45duro/ProyectoBarredor/Materiales/Listado Materiales.xlsx

Producto | Cantidad | Costo | Total | Tienda
Base en L para Motor de 37MM | 4 | 7045 | 28180 | https://www.vistronica.com/robotica/accesorios-mecanicos/base-en-l-para-motor-de-37mm-detail.html
Motoreductor 18 kgcm | 4 | 76900 | 307600 | https://www.dynamoelectronics.com/motorreductores/536-motorreductor-18kgcm-80rpm.html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
