45duro/ProyectoBarredor/Chasis/ChasisConBasesMotor.SLDASM

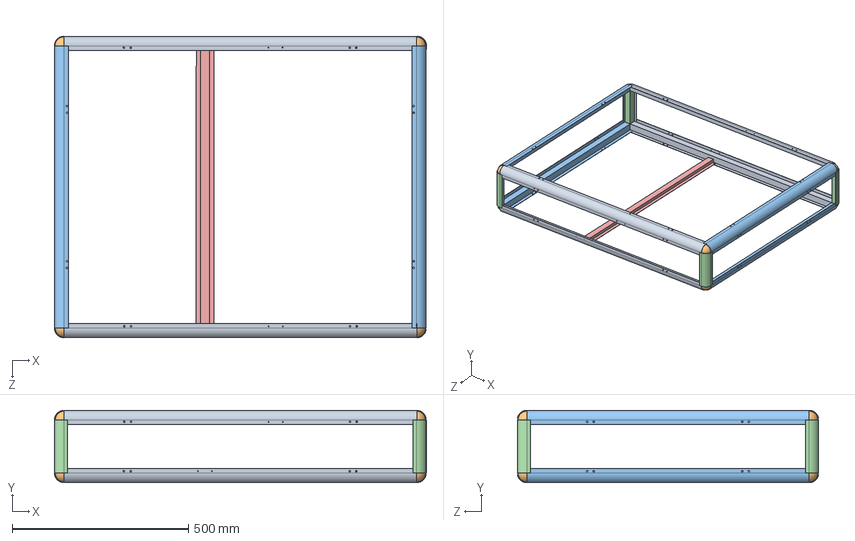
[picture p1: CAD file, 2019-09-19]
Chasis/ChasisConBasesMotor.SLDASM
1054.8 x 204.8 x 854.8 mm
Angulo x 4
Angulo 90 perfil x 8
AnguloFrontal x 4
AnguloParal x 4
Perfil Cuadrado
