45duro/ProyectoBarredor/Explosion Vista.SLDASM

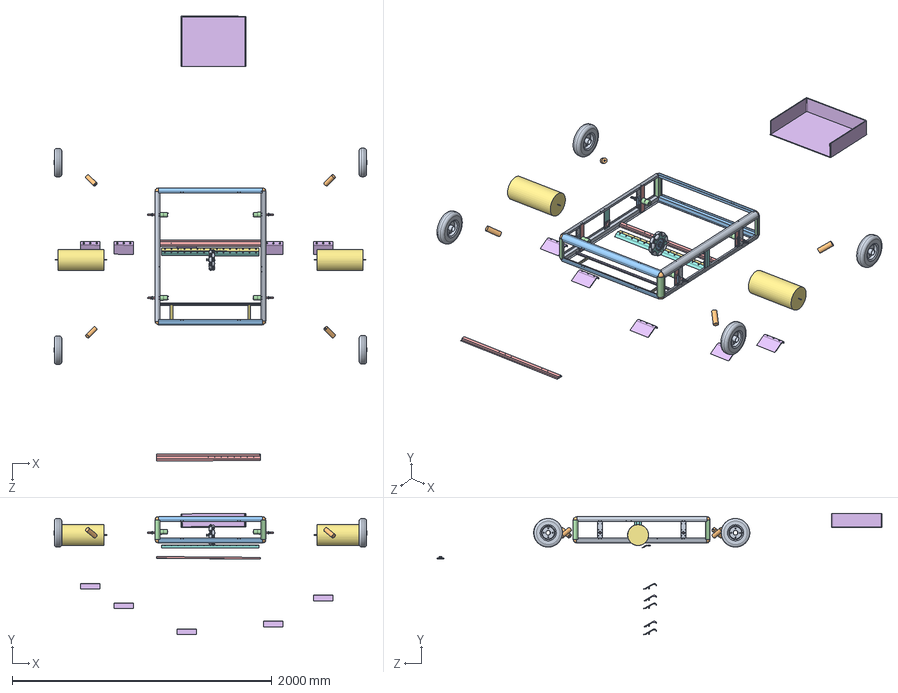
[picture p2: CAD file, 2019-09-28]
Explosion Vista.SLDASM
2407.9 x 934.3 x 3420.2 mm
Angulo x 4
Angulo 90 perfil x 8
AnguloFrontal x 4
AnguloParal x 4
Perfil Cuadrado x 2
pala2 x 5
protecto pala x 5
cinta flexy Recogedor
soporte Llantas x 4
instrument ball bearing_ai x 4
SOPORTE BALINERA x 4
hex jam nut_ai x 4
heavy hex finished bolt_ai x 4
soporte en T
soporte en T pequeño x 2
base1 x 2
tambor x 14
AdaptadorM2R
AdaptadorM3R
Soporte Lateral Rodillo x 2
Anillos Rodillo2 x 2
Cepillo x 2
Perfil Cuadrado 15cm x 2
Llanta x 4
Sujetadores Llantas x 4
Suplemento Transmision x 8
Motores Pololu x 4
soporte motor x 4
Canastilla
