45duro/ProyectoBarredor/Omnidireccion/LLanta OmniDir.SLDASM

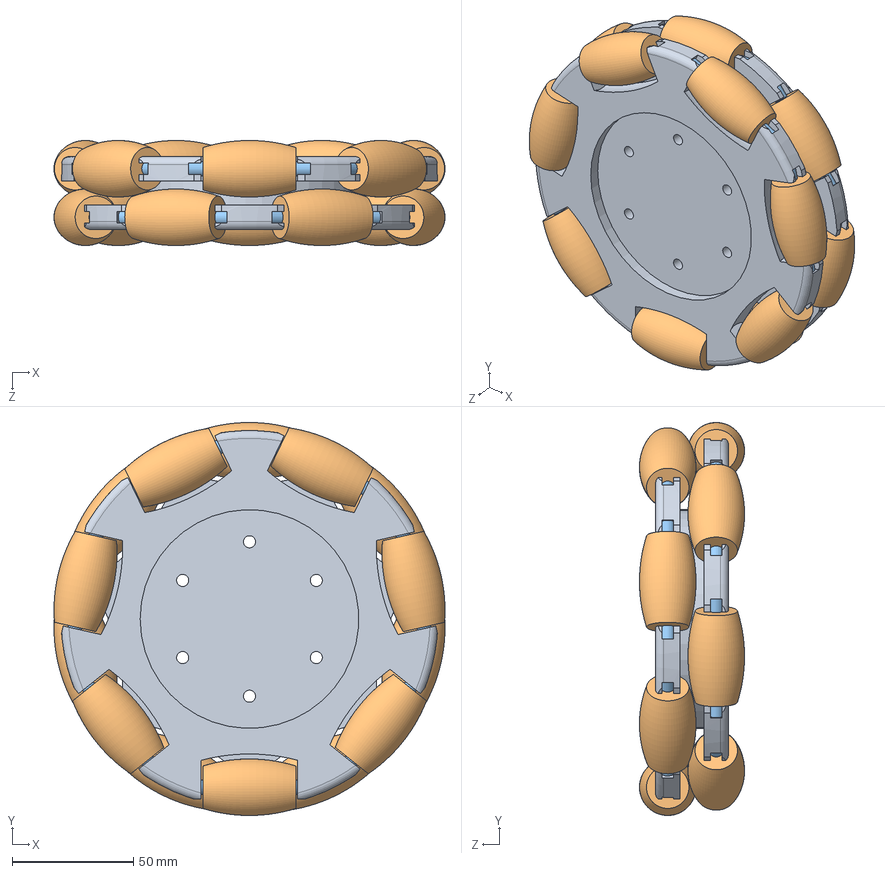
[picture p3: CAD file, 2019-09-19]
Omnidireccion/LLanta OmniDir.SLDASM
161.1 x 161.9 x 43.3 mm
base1 x 2
tambor x 14
