45duro/ProyectoBarredor/Chasis/Chasis Con Pala.SLDASM

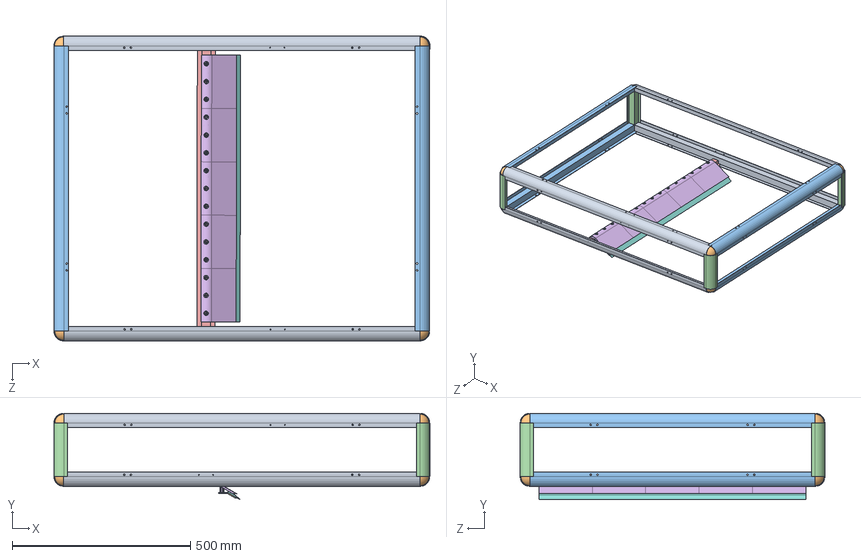
[picture p5: CAD file, 2019-09-19]
Chasis/Chasis Con Pala.SLDASM
1054.8 x 242.1 x 854.8 mm
Angulo x 4
Angulo 90 perfil x 8
AnguloFrontal x 4
AnguloParal x 4
Perfil Cuadrado
pala2 x 5
protecto pala x 5
cinta flexy Recogedor
