45duro/ProyectoBarredor/Pala Recogedor/Pala Final con cinta.SLDASM

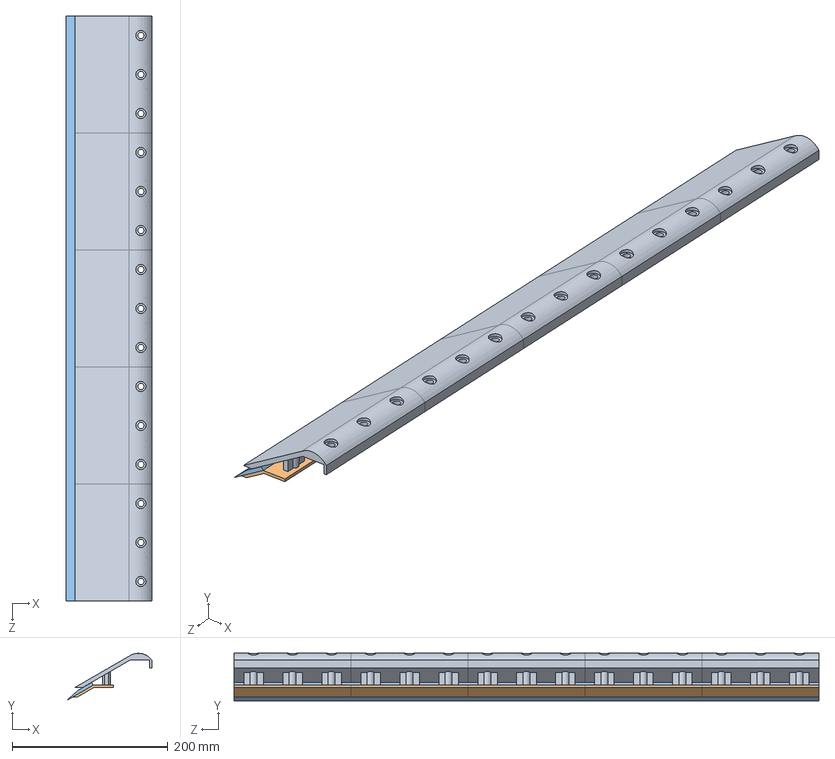
[picture p6: CAD file, 2019-09-17]
Pala Recogedor/Pala Final con cinta.SLDASM
109.8 x 60.9 x 750.0 mm
pala2 x 5
protecto pala x 5
cinta flexy Recogedor
