45duro/ProyectoBarredor/Sistema de Arrastre/Llanta Fija.SLDASM

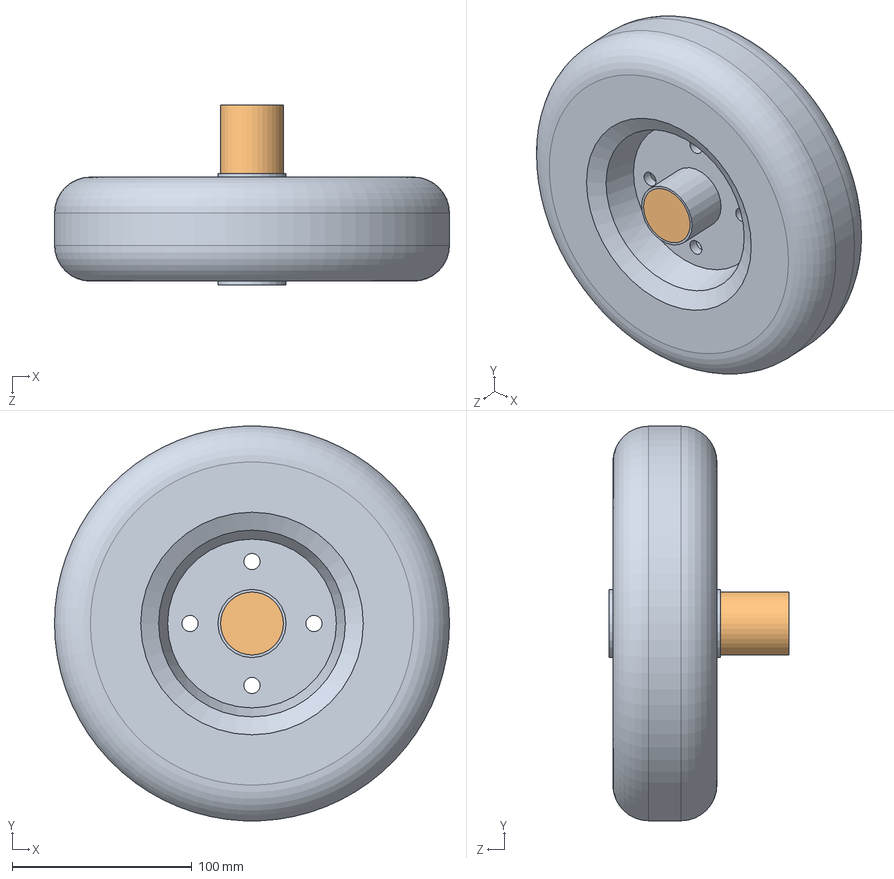
[picture p7: CAD file, 2019-09-19]
Sistema de Arrastre/Llanta Fija.SLDASM
220.0 x 219.8 x 100.0 mm
Llanta
Sujetadores Llantas
