45duro/ProyectoBarredor/Transmision/Soporte Principal Del Chasis.SLDASM

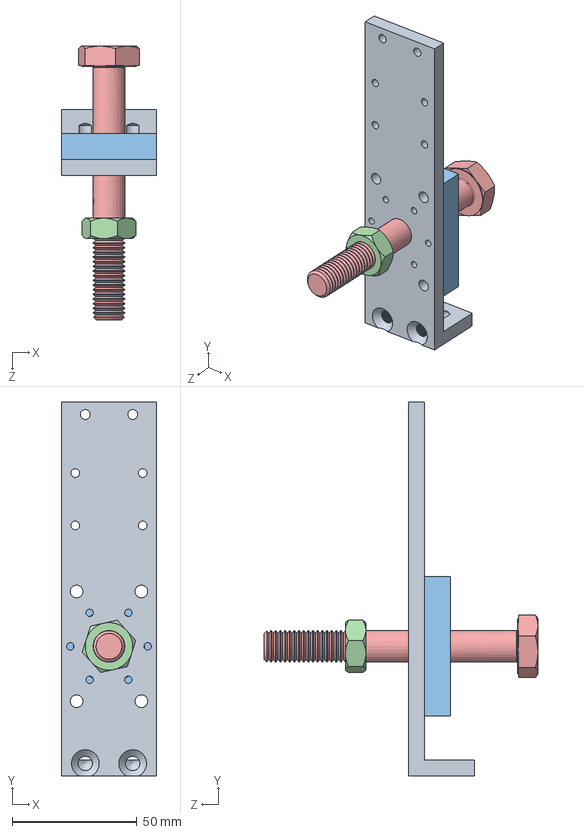
[picture p8: CAD file, 2019-09-19]
Transmision/Soporte Principal Del Chasis.SLDASM
38.0 x 150.0 x 109.8 mm
soporte Llantas
instrument ball bearing_ai
SOPORTE BALINERA
hex jam nut_ai
heavy hex finished bolt_ai
