45duro/ProyectoBarredor/Omnidireccion/OmniRueda.SLDASM

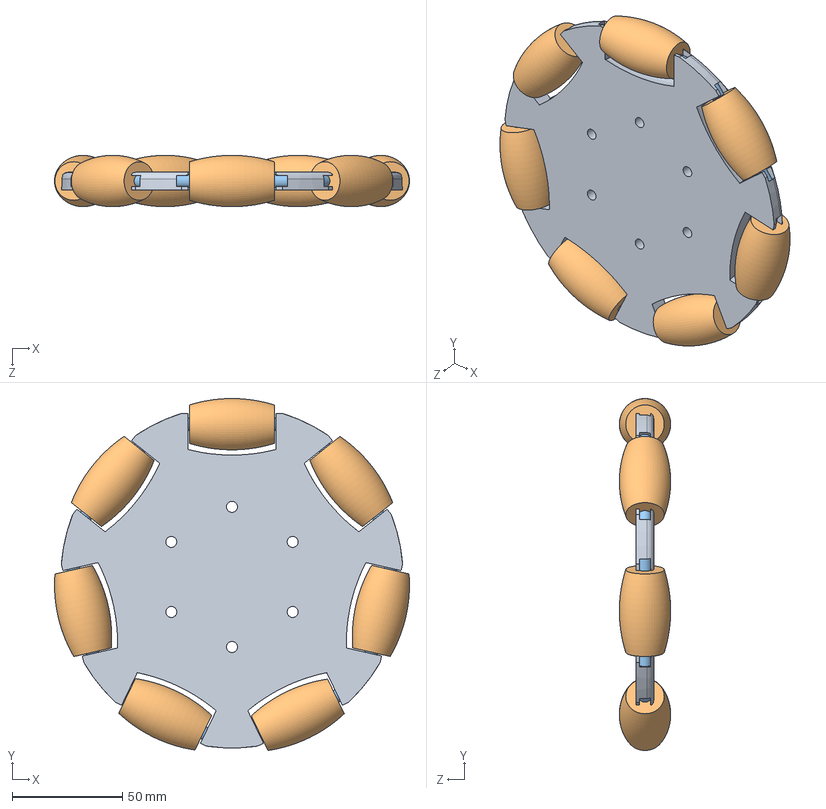
[picture p10: CAD file, 2019-09-19]
Omnidireccion/OmniRueda.SLDASM
161.1 x 159.7 x 23.3 mm
base1
tambor x 7
