45duro/ProyectoBarredor/Pala Recogedor/Pala Final.SLDASM

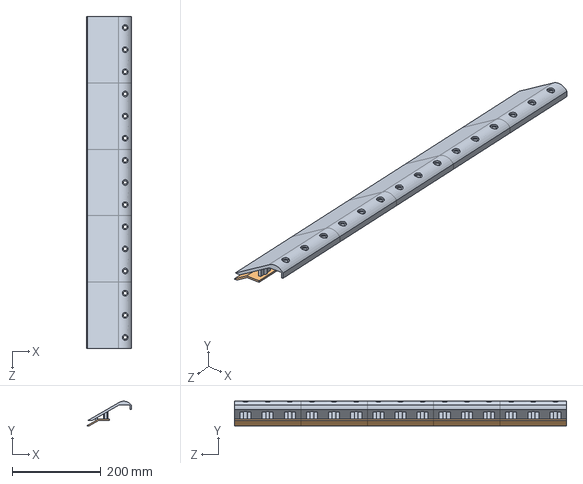
[picture p11: CAD file, 2019-09-17]
Pala Recogedor/Pala Final.SLDASM
101.0 x 55.9 x 750.0 mm
pala2 x 5
protecto pala x 5
