45duro/ProyectoBarredor/Perfiles/MarcoBaseParales.SLDASM

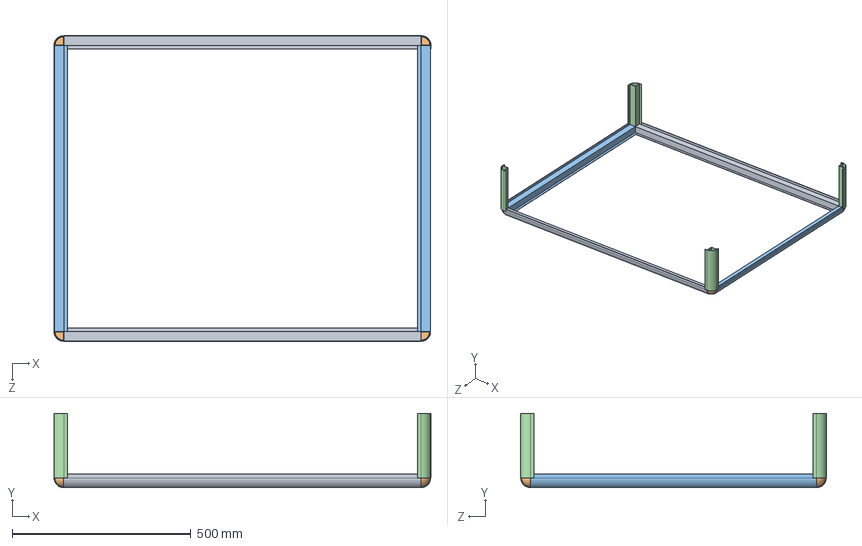
[picture p12: CAD file, 2019-09-17]
Perfiles/MarcoBaseParales.SLDASM
1054.8 x 207.4 x 854.8 mm
Angulo x 2
Angulo 90 perfil x 4
AnguloFrontal x 2
AnguloParal x 4
