45duro/ProyectoBarredor/Rodillo/Cepillo Completo.SLDASM

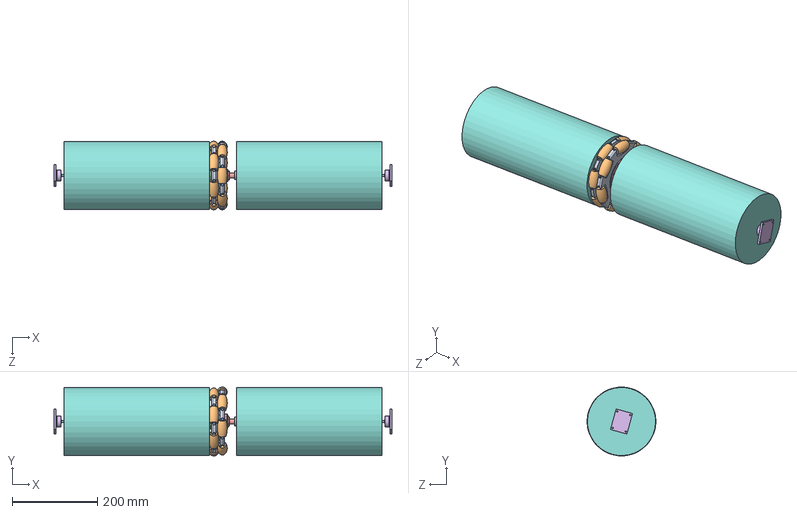
[picture p13: CAD file, 2019-09-19]
Rodillo/Cepillo Completo.SLDASM
793.7 x 161.9 x 161.1 mm
base1 x 2
tambor x 14
AdaptadorM2R
AdaptadorM3R
Soporte Lateral Rodillo x 2
Anillos Rodillo2 x 2
Cepillo x 2
