45duro/ProyectoBarredor/Transmision/Motor Montado.SLDASM

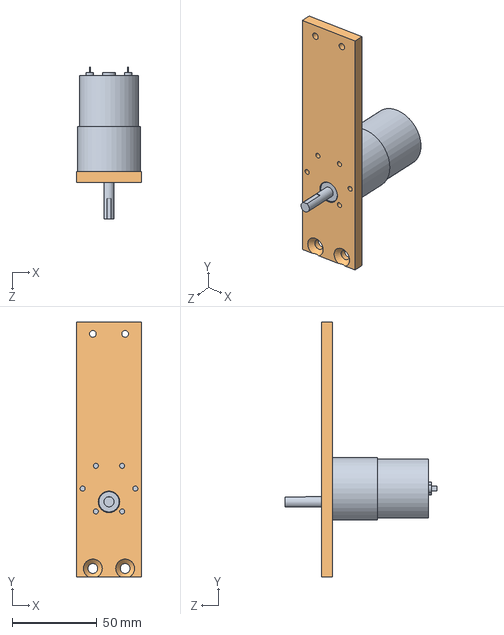
[picture p14: CAD file, 2019-09-19]
Transmision/Motor Montado.SLDASM
38.0 x 150.0 x 89.5 mm
Motores Pololu
soporte motor
