45duro/ProyectoBarredor/Rodillo/Cepillo Medio Ensamble.SLDASM

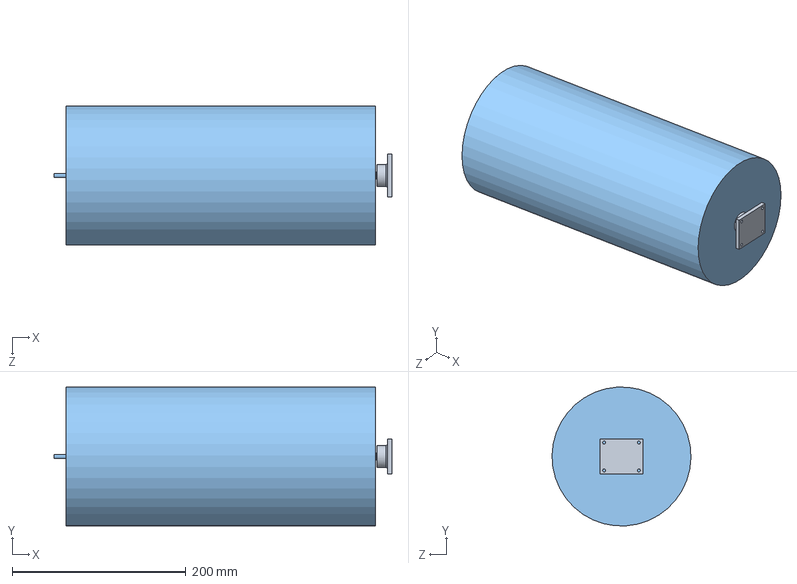
[picture p15: CAD file, 2019-09-19]
Rodillo/Cepillo Medio Ensamble.SLDASM
389.0 x 159.6 x 160.0 mm
Soporte Lateral Rodillo
Anillos Rodillo2
Cepillo
