45duro/ProyectoBarredor/Pala Recogedor/SoportePala.SLDASM

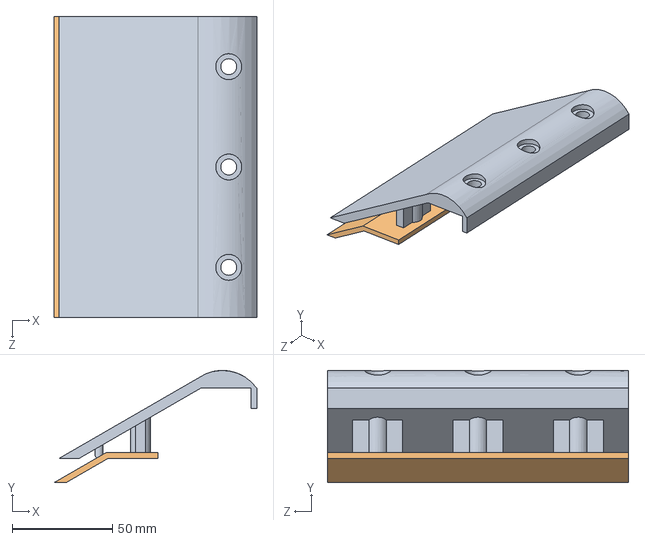
[picture p16: CAD file, 2019-09-17]
Pala Recogedor/SoportePala.SLDASM
101.0 x 55.9 x 150.0 mm
pala2
protecto pala
