45duro/ProyectoBarredor/Perfiles/MarcoBase.SLDASM

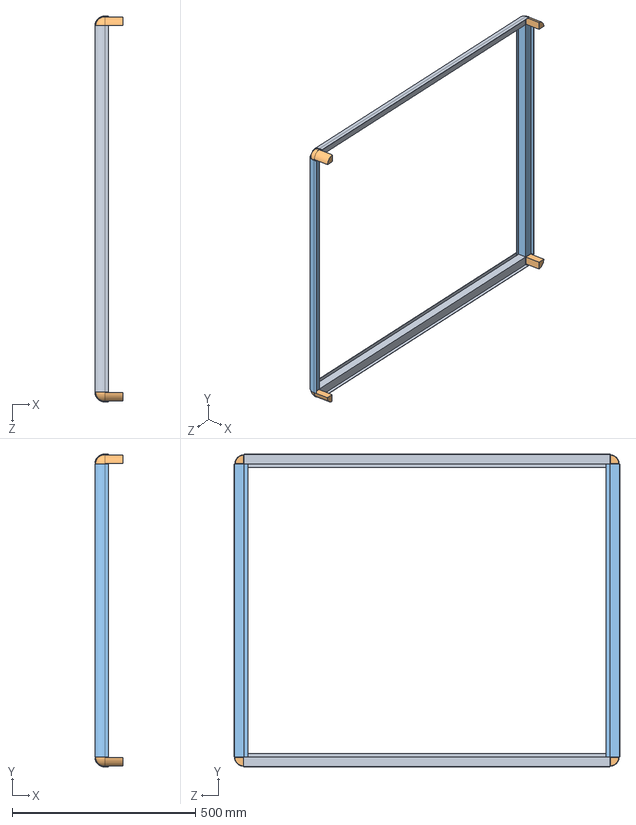
[picture p17: CAD file, 2019-09-17]
Perfiles/MarcoBase.SLDASM
77.4 x 854.8 x 1053.8 mm
Angulo x 2
Angulo 90 perfil x 4
AnguloFrontal x 2
