45duro/ProyectoBarredor/Pala Recogedor/Ensamblaje6.SLDASM

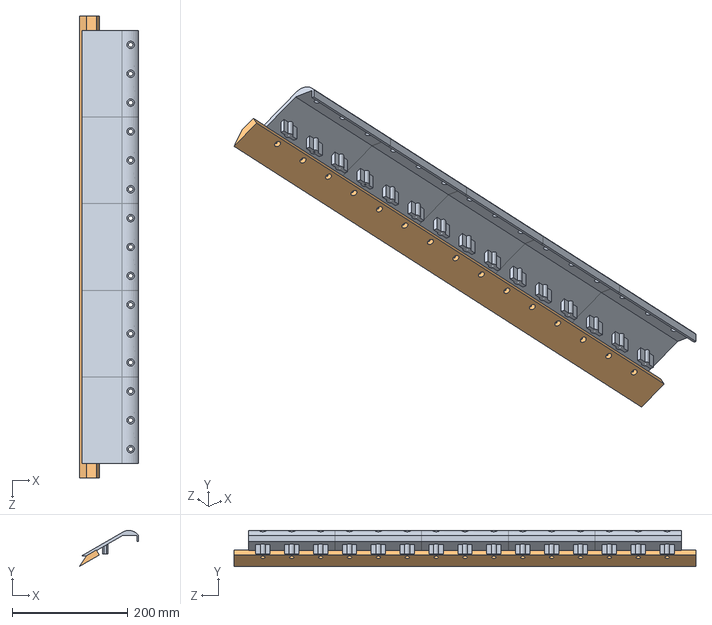
[picture p18: CAD file, 2019-08-01]
Pala Recogedor/Ensamblaje6.SLDASM
102.9 x 62.5 x 800.0 mm
pala2 x 5
cinta flexy Recogedor
