45duro/ProyectoBarredor/Omnidireccion/Rueda Doble Emsablada.SLDASM

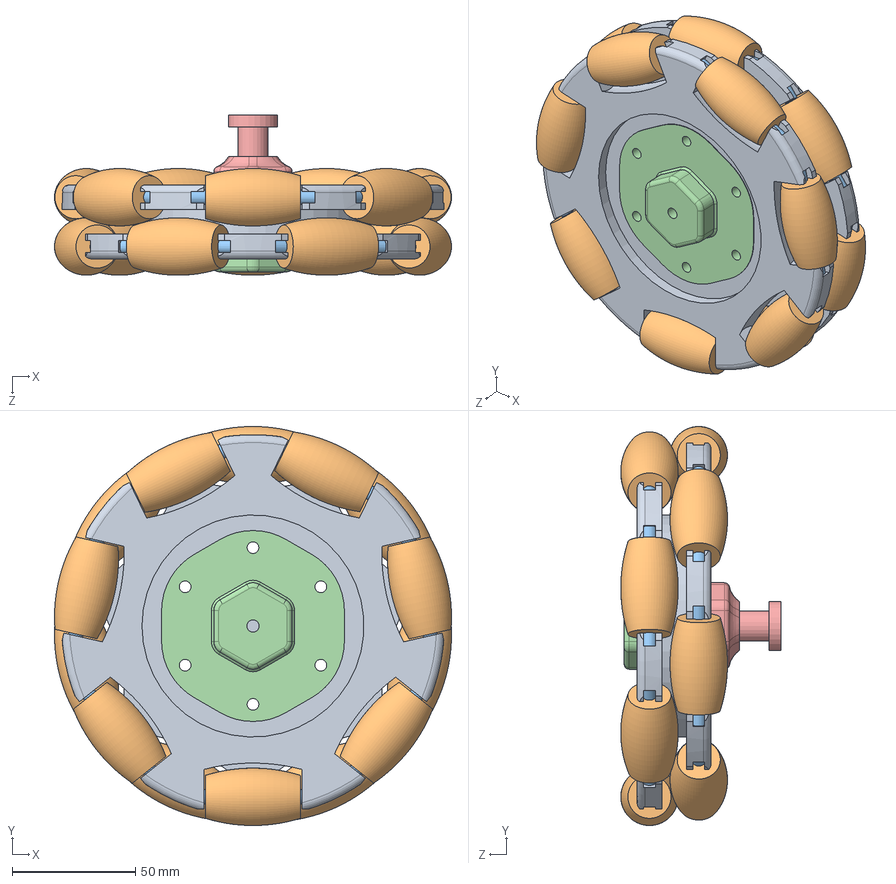
[picture p19: CAD file, 2019-09-19]
Omnidireccion/Rueda Doble Emsablada.SLDASM
161.1 x 161.9 x 65.1 mm
base1 x 2
tambor x 14
AdaptadorM2R
AdaptadorM3R
