45duro/ProyectoBarredor/Pala Recogedor/PALAS UNIDAS.SLDASM

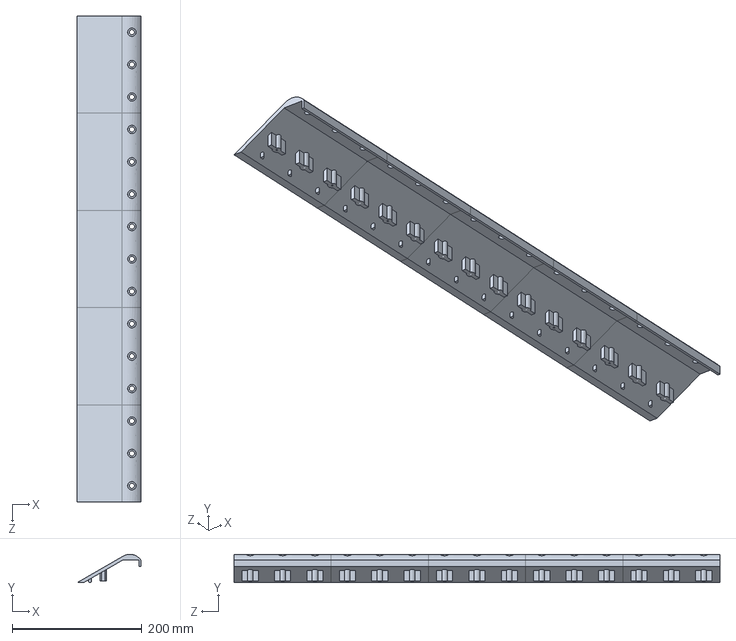
[picture p20: CAD file, 2019-08-01]
Pala Recogedor/PALAS UNIDAS.SLDASM
98.6 x 43.9 x 750.0 mm
pala2 x 5
