45duro/ProyectoBarredor/Canasta/Canastilla.SLDPRT

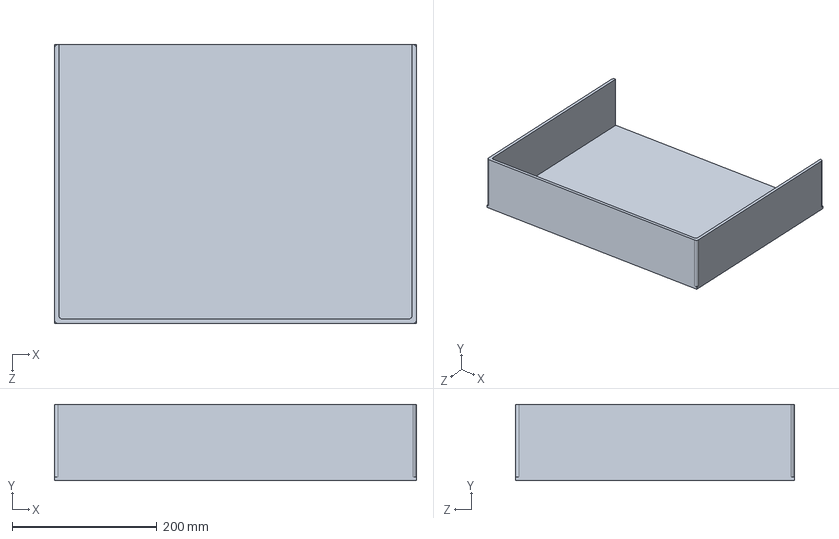
[picture p21: CAD file, 2019-09-19]
Canasta/Canastilla.SLDPRT
500.0 x 105.0 x 385.0 mm
