45duro/ProyectoBarredor/Pala Recogedor/cinta flexy Recogedor.SLDPRT

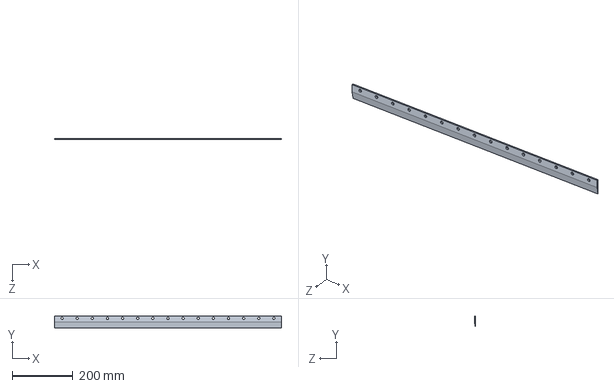
[picture p22: CAD file, 2019-09-17]
Pala Recogedor/cinta flexy Recogedor.SLDPRT
750.0 x 40.0 x 4.00 mm
