45duro/ProyectoBarredor/Perfiles/Perfil Cuadrado 15cm.SLDPRT

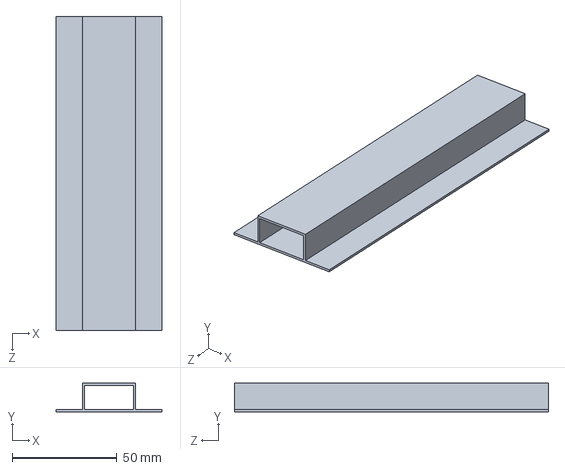
[picture p23: CAD file, 2019-09-19]
Perfiles/Perfil Cuadrado 15cm.SLDPRT
50.8 x 13.7 x 150.0 mm
