45duro/ProyectoBarredor/Rodillo/Anillos Rodillo2.SLDPRT

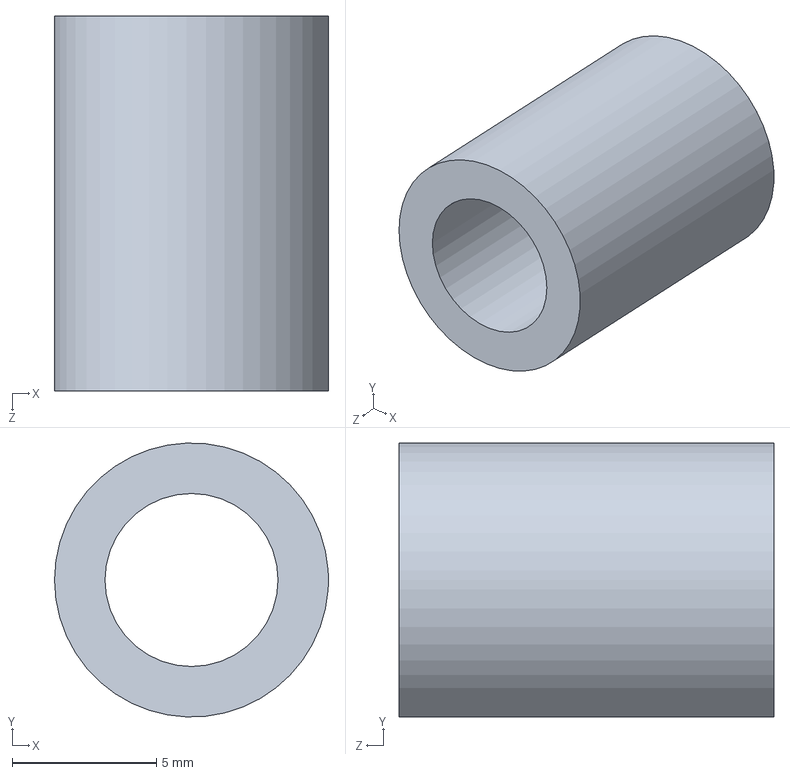
[picture p24: CAD file, 2019-09-19]
Rodillo/Anillos Rodillo2.SLDPRT
9.50 x 9.49 x 13.0 mm
