45duro/ProyectoBarredor/Sistema de Arrastre/Motores Pololu.SLDPRT

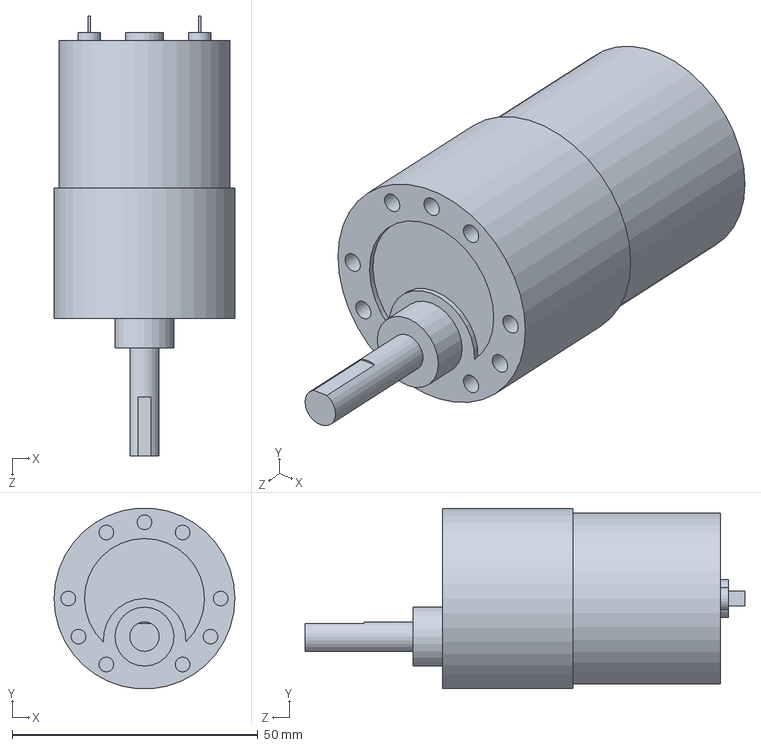
[picture p25: CAD file, 2019-11-28]
Sistema de Arrastre/Motores Pololu.SLDPRT
36.8 x 36.7 x 89.5 mm
