45duro/ProyectoBarredor/Transmision/soporte motor.SLDPRT

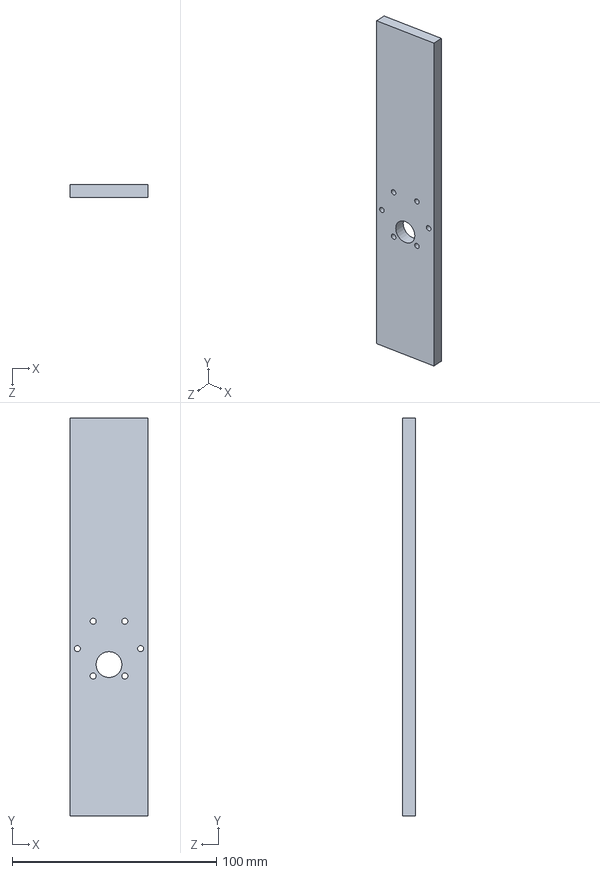
[picture p26: CAD file, 2019-09-19]
Transmision/soporte motor.SLDPRT
38.0 x 195.0 x 6.35 mm
