45duro/ProyectoBarredor/Omnidireccion/Part1.SLDPRT

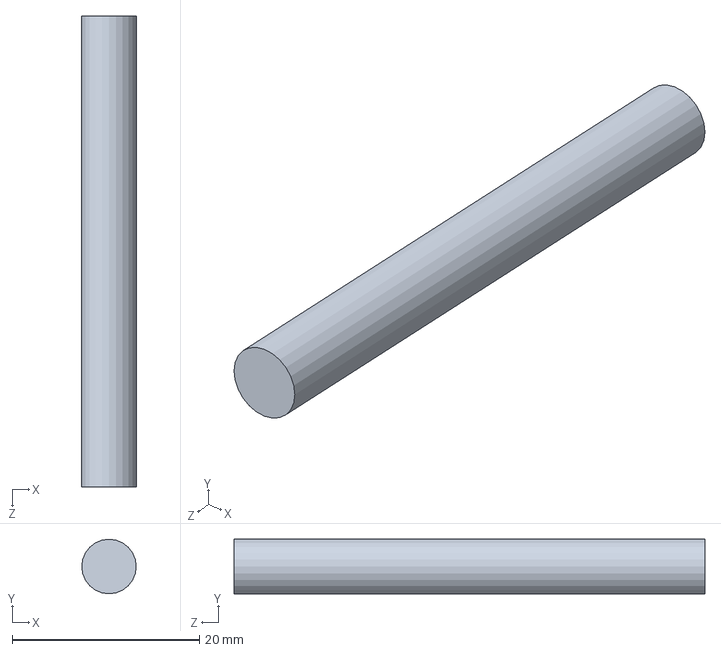
[picture p27: CAD file, 2019-09-19]
Omnidireccion/Part1.SLDPRT
5.83 x 5.83 x 50.3 mm
