45duro/ProyectoBarredor/Perfiles/soporte en T.SLDPRT

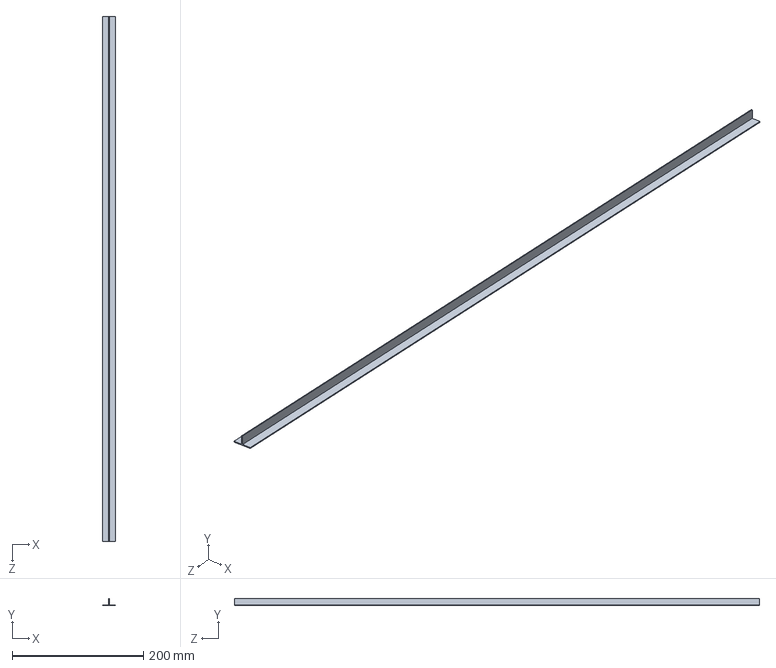
[picture p28: CAD file, 2019-09-17]
Perfiles/soporte en T.SLDPRT
20.0 x 10.5 x 800.0 mm
