45duro/ProyectoBarredor/Rodillo/Cepillo.SLDPRT

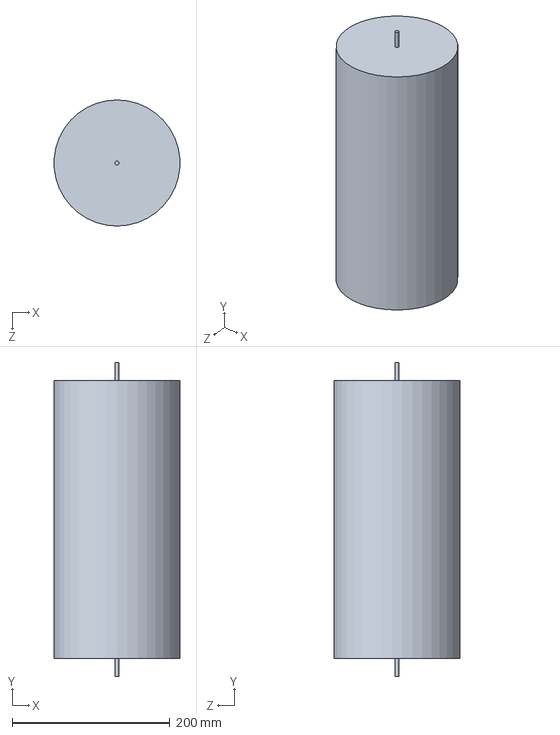
[picture p29: CAD file, 2019-09-19]
Rodillo/Cepillo.SLDPRT
159.5 x 398.4 x 160.0 mm
