45duro/ProyectoBarredor/STL/tambor.STL

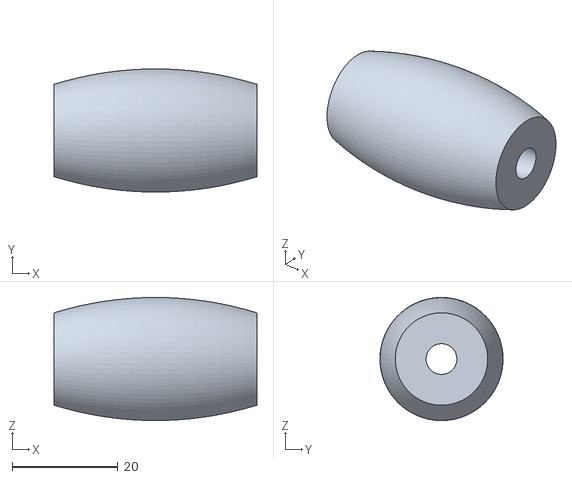
[picture p30: CAD file, 2019-08-01]
STL/tambor.STL
38.4 x 23.3 x 23.3
