45duro/ProyectoBarredor/Pala Recogedor/protecto pala.SLDPRT

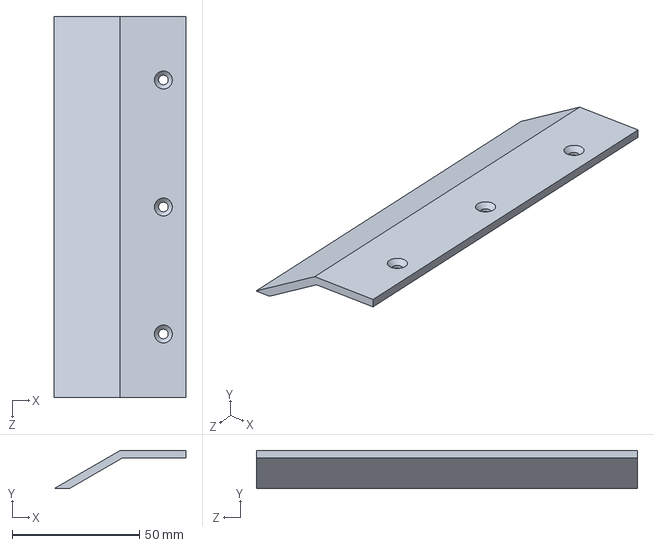
[picture p31: CAD file, 2019-09-17]
Pala Recogedor/protecto pala.SLDPRT
51.8 x 15.0 x 150.0 mm
