45duro/ProyectoBarredor/Perfiles/Angulo 90 perfil.SLDPRT

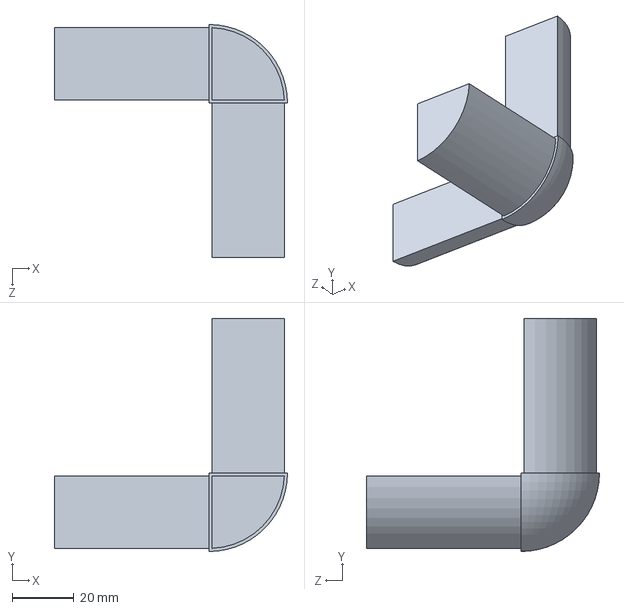
[picture p32: CAD file, 2019-09-17]
Perfiles/Angulo 90 perfil.SLDPRT
75.4 x 75.4 x 75.4 mm
