45duro/ProyectoBarredor/Rodillo/Soporte Lateral Rodillo.SLDPRT

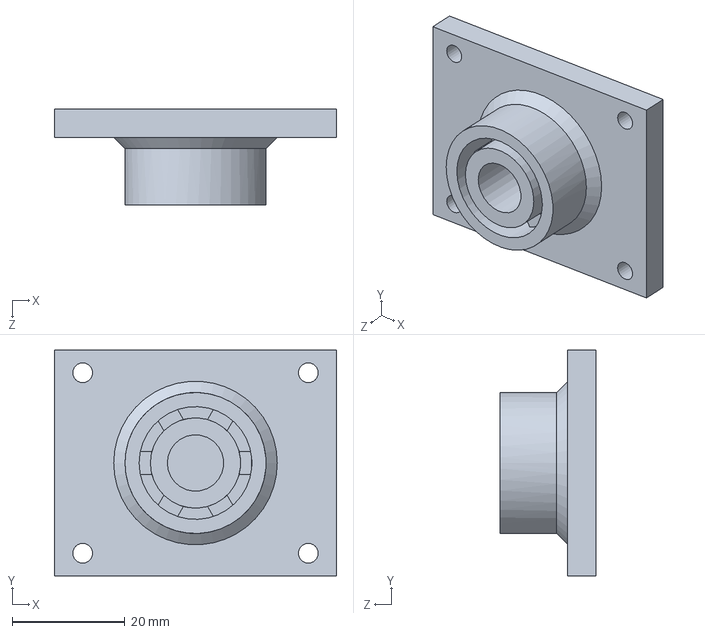
[picture p33: CAD file, 2019-09-19]
Rodillo/Soporte Lateral Rodillo.SLDPRT
50.0 x 40.0 x 17.0 mm
