45duro/ProyectoBarredor/Sistema de Arrastre/Sujetadores Llantas.SLDPRT

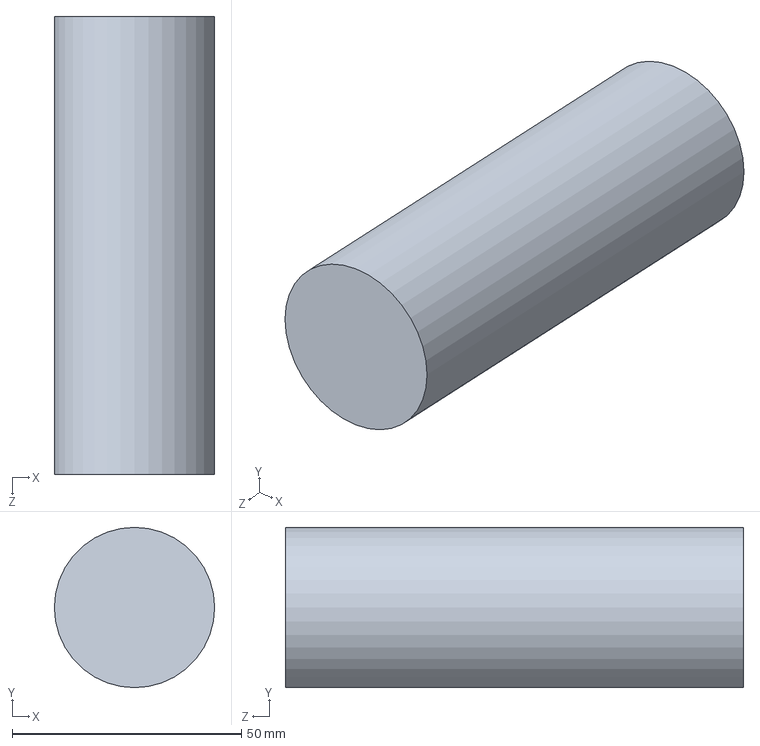
[picture p34: CAD file, 2019-09-19]
Sistema de Arrastre/Sujetadores Llantas.SLDPRT
35.0 x 35.0 x 100.0 mm
