45duro/ProyectoBarredor/Transmision/soporte Llantas.SLDPRT

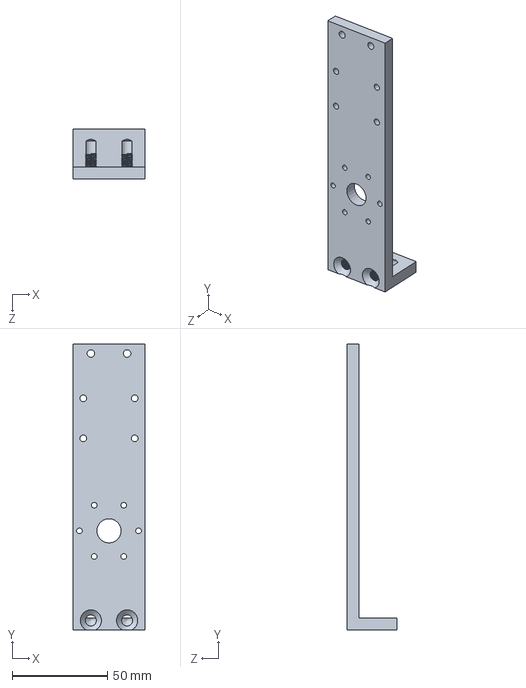
[picture p35: CAD file, 2019-09-19]
Transmision/soporte Llantas.SLDPRT
38.0 x 150.0 x 26.3 mm
