45duro/ProyectoBarredor/Omnidireccion/AdaptadorM2R.SLDPRT

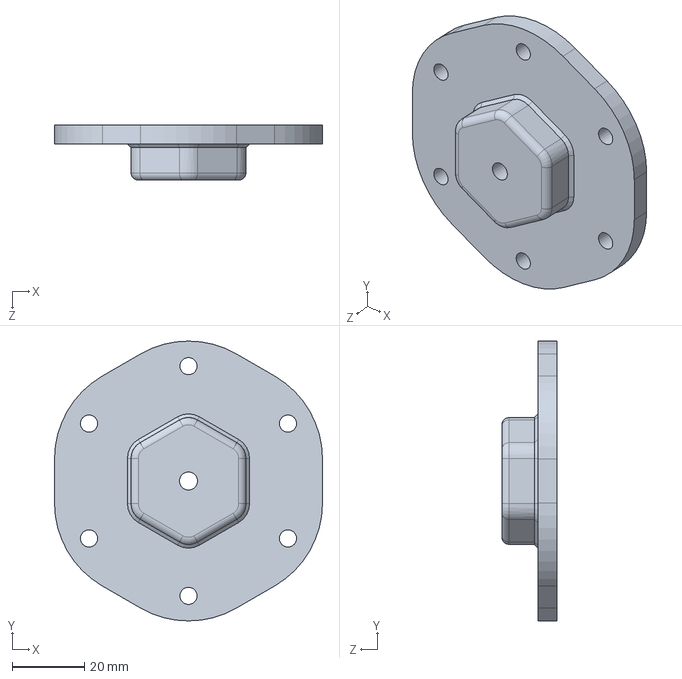
[picture p36: CAD file, 2019-09-19]
Omnidireccion/AdaptadorM2R.SLDPRT
74.2 x 77.5 x 15.3 mm
