45duro/ProyectoBarredor/Sistema de Arrastre/Llanta.SLDPRT

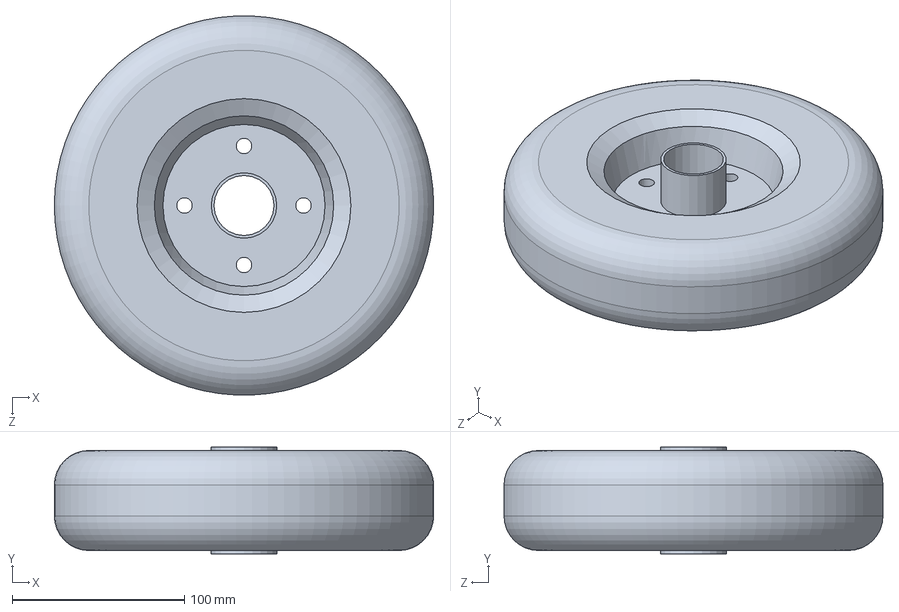
[picture p37: CAD file, 2019-09-19]
Sistema de Arrastre/Llanta.SLDPRT
220.0 x 62.0 x 219.8 mm
