45duro/ProyectoBarredor/STL/AdaptadorM3R.STL

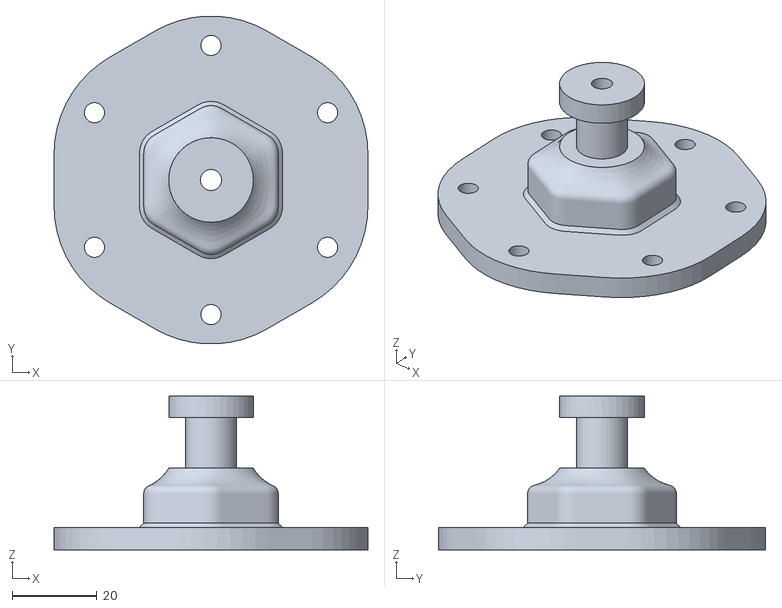
[picture p38: CAD file, 2019-08-01]
STL/AdaptadorM3R.STL
74.2 x 77.4 x 36.3
