45duro/ProyectoBarredor/Pala Recogedor/pala2.SLDPRT

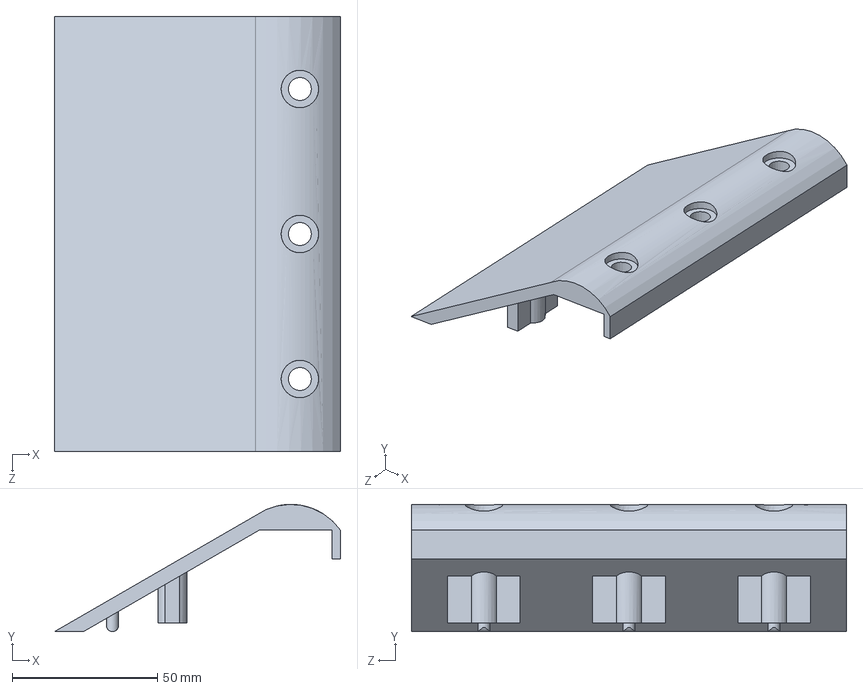
[picture p39: CAD file, 2019-09-17]
Pala Recogedor/pala2.SLDPRT
98.6 x 43.9 x 150.0 mm
