45duro/ProyectoBarredor/Perfiles/Angulo.SLDPRT

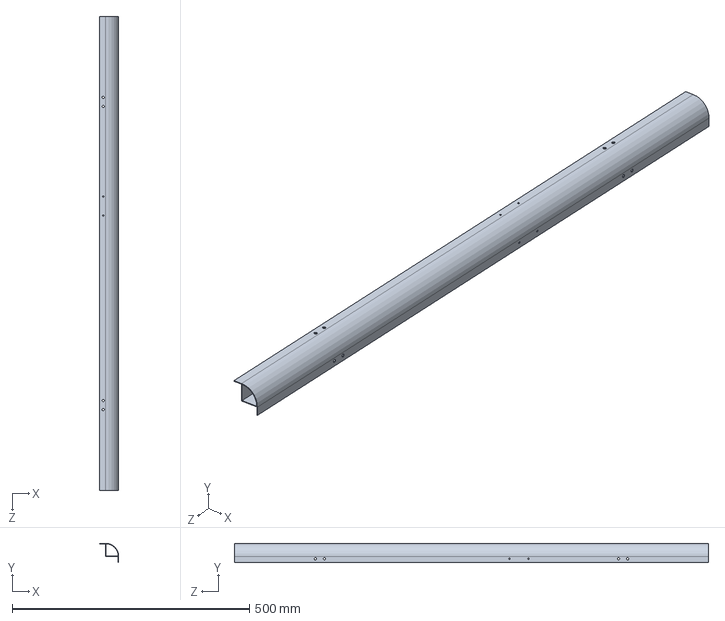
[picture p40: CAD file, 2019-09-17]
Perfiles/Angulo.SLDPRT
40.4 x 40.4 x 1000.0 mm
