45duro/ProyectoBarredor/Transmision/Ejes LLantas.SLDPRT

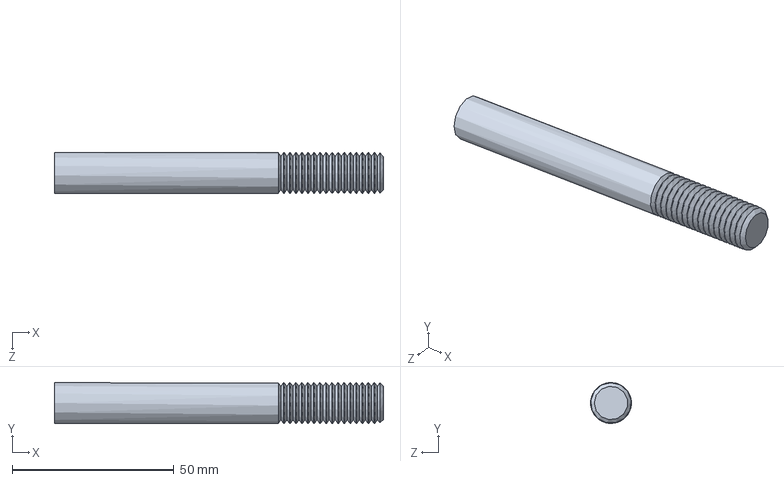
[picture p41: CAD file, 2019-09-19]
Transmision/Ejes LLantas.SLDPRT
101.9 x 12.7 x 12.7 mm
