45duro/ProyectoBarredor/Omnidireccion/base1.SLDPRT

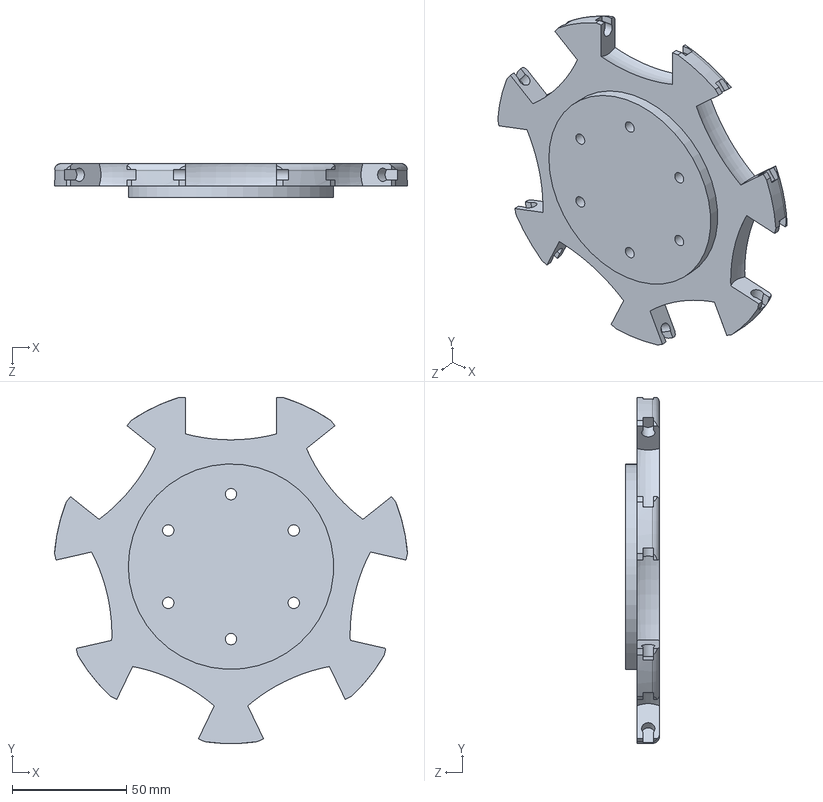
[picture p42: CAD file, 2019-09-19]
Omnidireccion/base1.SLDPRT
154.8 x 151.7 x 15.0 mm
