45duro/ProyectoBarredor/Transmision/SOPORTE BALINERA.SLDPRT

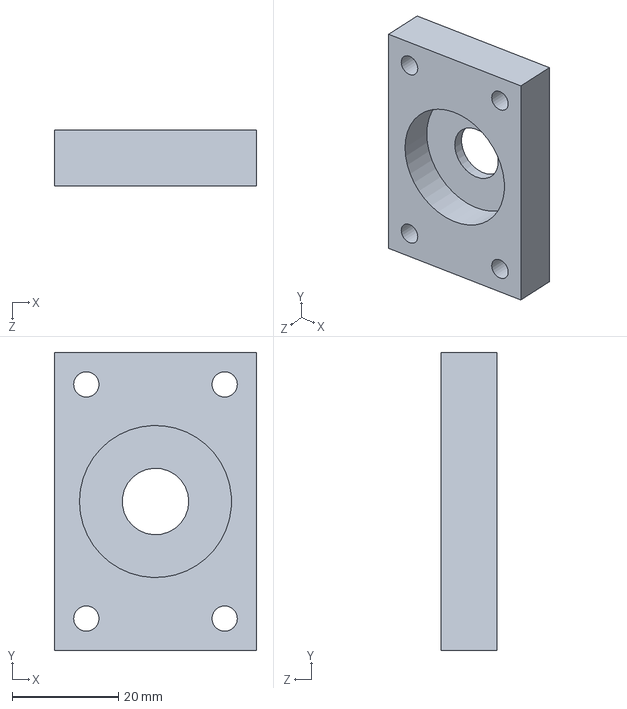
[picture p43: CAD file, 2019-09-17]
Transmision/SOPORTE BALINERA.SLDPRT
38.0 x 56.0 x 10.5 mm
