45duro/ProyectoBarredor/Perfiles/soporte en T pequeño.SLDPRT

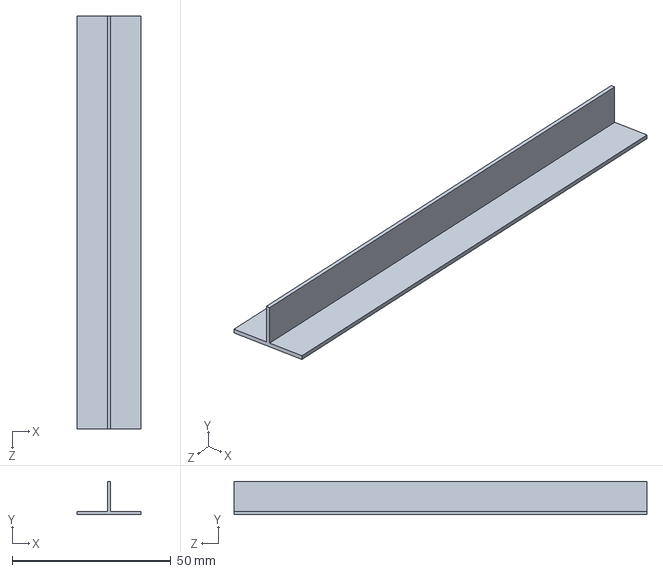
[picture p44: CAD file, 2019-09-17]
Perfiles/soporte en T pequeño.SLDPRT
20.0 x 10.5 x 130.0 mm
