45duro/ProyectoBarredor/STL/Anillos Rodillo.STL

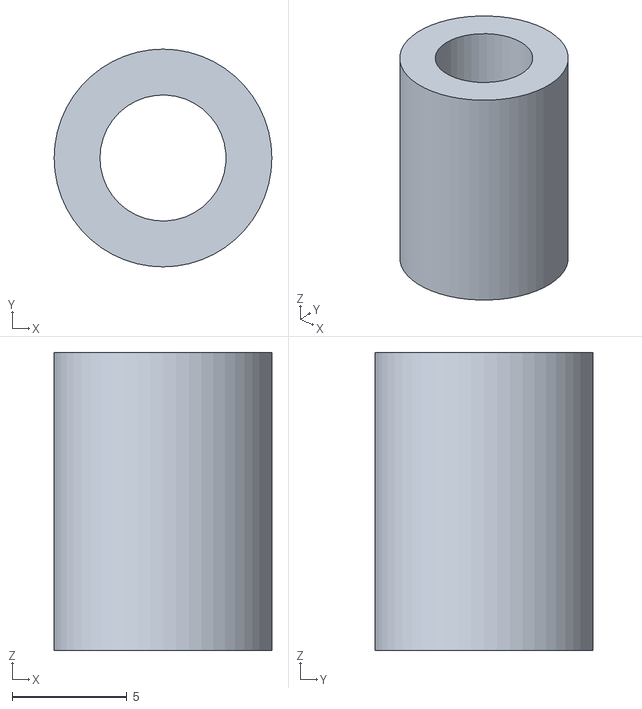
[picture p45: CAD file, 2019-08-01]
STL/Anillos Rodillo.STL
9.50 x 9.50 x 13.0
