45duro/ProyectoBarredor/Transmision/Tuerca.SLDPRT

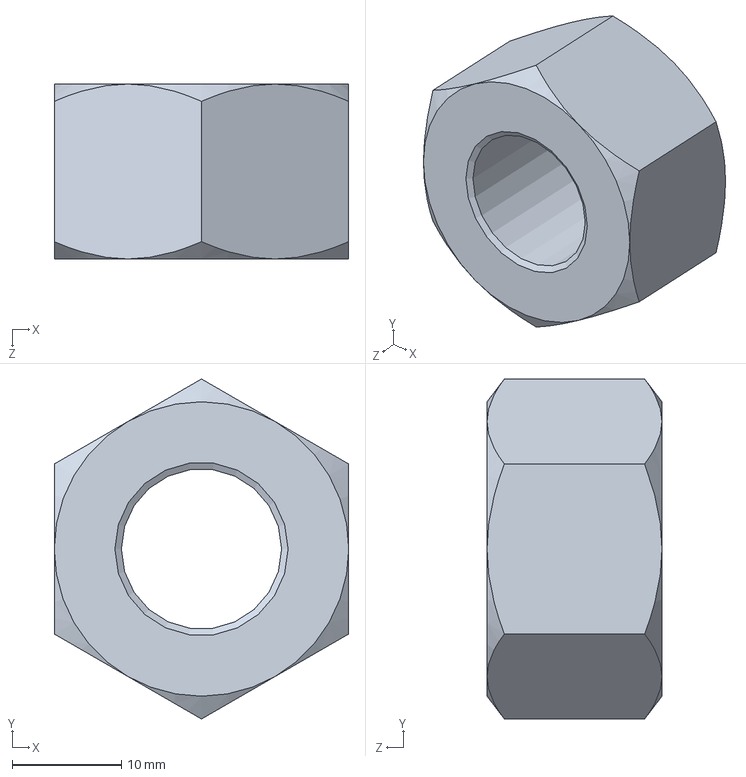
[picture p46: CAD file, 2019-09-17]
Transmision/Tuerca.SLDPRT
27.0 x 31.1 x 16.0 mm
