45duro/ProyectoBarredor/Perfiles/Perfil Cuadrado.SLDPRT

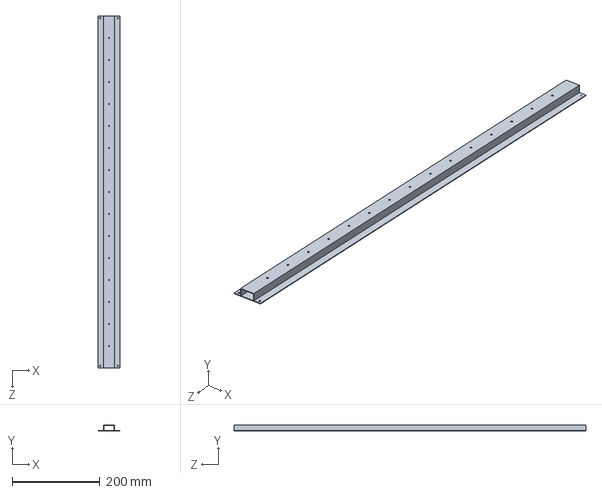
[picture p47: CAD file, 2019-09-17]
Perfiles/Perfil Cuadrado.SLDPRT
50.8 x 13.7 x 800.0 mm
