45duro/ProyectoBarredor/Transmision/Rodamiento Rodillo Llanta.sldprt

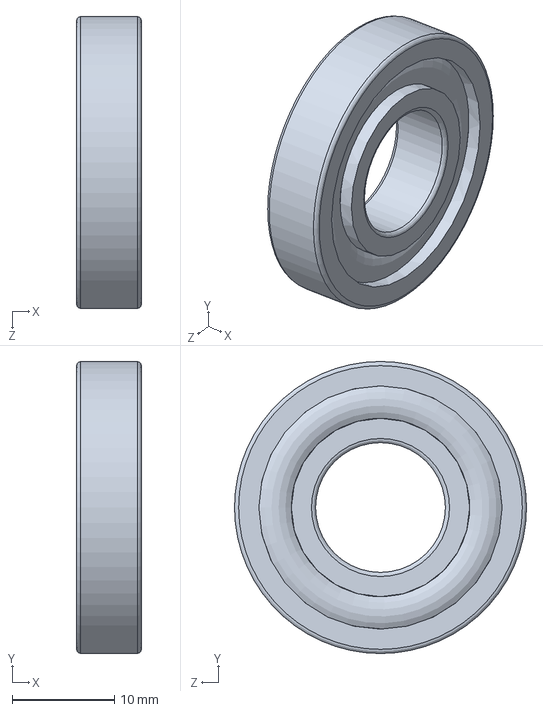
[picture p48: CAD file, 2019-09-17]
Transmision/Rodamiento Rodillo Llanta.sldprt
6.35 x 28.6 x 28.6 mm
