45duro/ProyectoBarredor/Perfiles/AnguloParal.SLDPRT

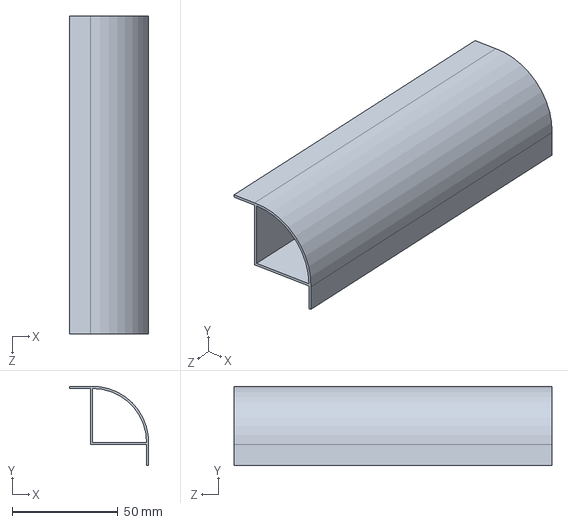
[picture p49: CAD file, 2019-09-17]
Perfiles/AnguloParal.SLDPRT
37.4 x 37.4 x 150.0 mm
