45duro/ProyectoBarredor/Transmision/Suplemento Transmision.SLDPRT

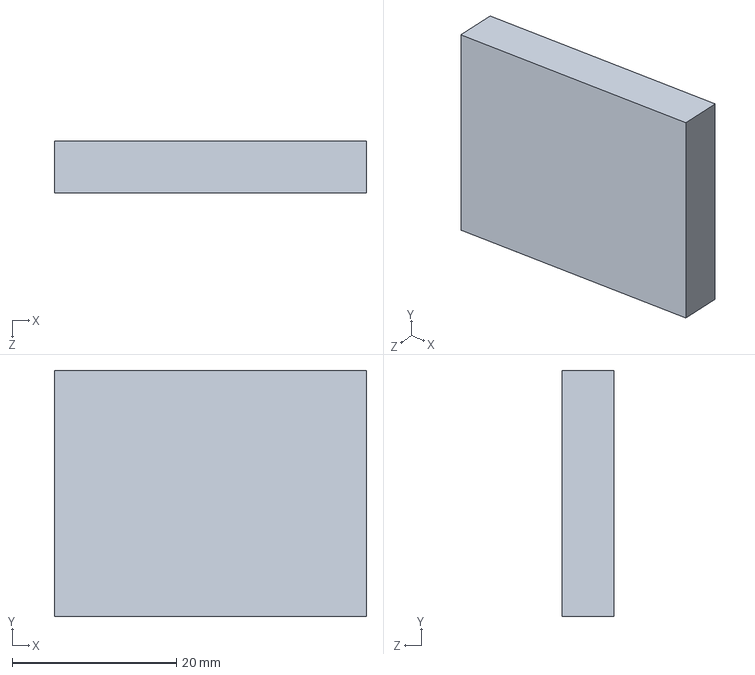
[picture p50: CAD file, 2019-09-17]
Transmision/Suplemento Transmision.SLDPRT
38.0 x 30.0 x 6.35 mm
