45duro/ProyectoBarredor/Perfiles/AnguloFrontal.SLDPRT

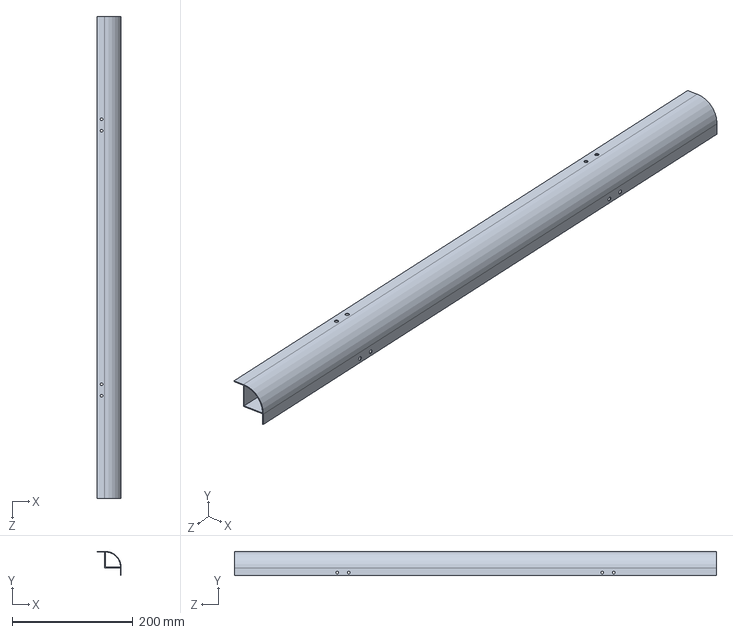
[picture p51: CAD file, 2019-09-17]
Perfiles/AnguloFrontal.SLDPRT
40.4 x 40.4 x 800.0 mm
