45duro/ProyectoBarredor/STL/acople Llanta.STL

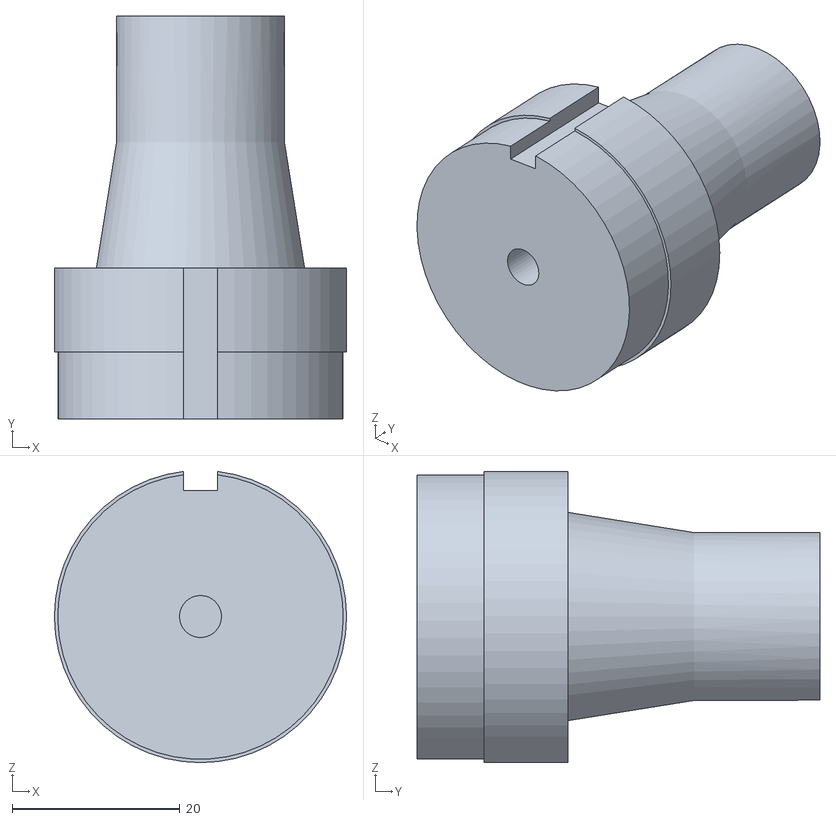
[picture p52: CAD file, 2019-07-26]
STL/acople Llanta.STL
34.8 x 48.0 x 34.7
