45duro/ProyectoBarredor/(list of files, cad)

Other CAD files:
STL/Anillos Rodillo2.STL
STL/soportes Laterales Rodillo.STL
Omnidireccion/tambor.SLDPRT
STL/AdaptadorM2R.STL
STL/base1 omni.STL
Omnidireccion/AdaptadorM3R.SLDPRT
STL/protector pala.STL
STL/pala.STL
Transmision/Motores Pololu.SLDPRT
Omnidireccion/AdaptadorM2R.STL
Omnidireccion/base1.STL
Omnidireccion/tambor.STL
PLANOS PDF/AdaptadorM2R.SLDDRW
PLANOS PDF/AdaptadorM3R.SLDDRW
PLANOS PDF/Angulo 90 perfil.SLDDRW
PLANOS PDF/AnguloParal.SLDDRW
PLANOS PDF/Anillos Rodillo2.SLDDRW
PLANOS PDF/Chasis Completo.SLDDRW
PLANOS PDF/Llanta Fija.SLDDRW
PLANOS PDF/Motores Pololu.SLDDRW
PLANOS PDF/Perfil Cuadrado 15cm.SLDDRW
PLANOS PDF/Soporte Lateral Rodillo.SLDDRW
PLANOS PDF/base1 omni.SLDDRW
PLANOS PDF/pala2.SLDDRW
PLANOS PDF/protecto pala.SLDDRW
PLANOS PDF/tambor.SLDDRW
Perfiles/soporte en T.SLDDRW
Transmision/SOPORTE BALINERA.SLDDRW
Transmision/soporte Llantas.SLDDRW
