45duro/ProyectoBarredor/PLANOS PDF/Angulo 90 perfil - Hoja1.pdf

E E

F F

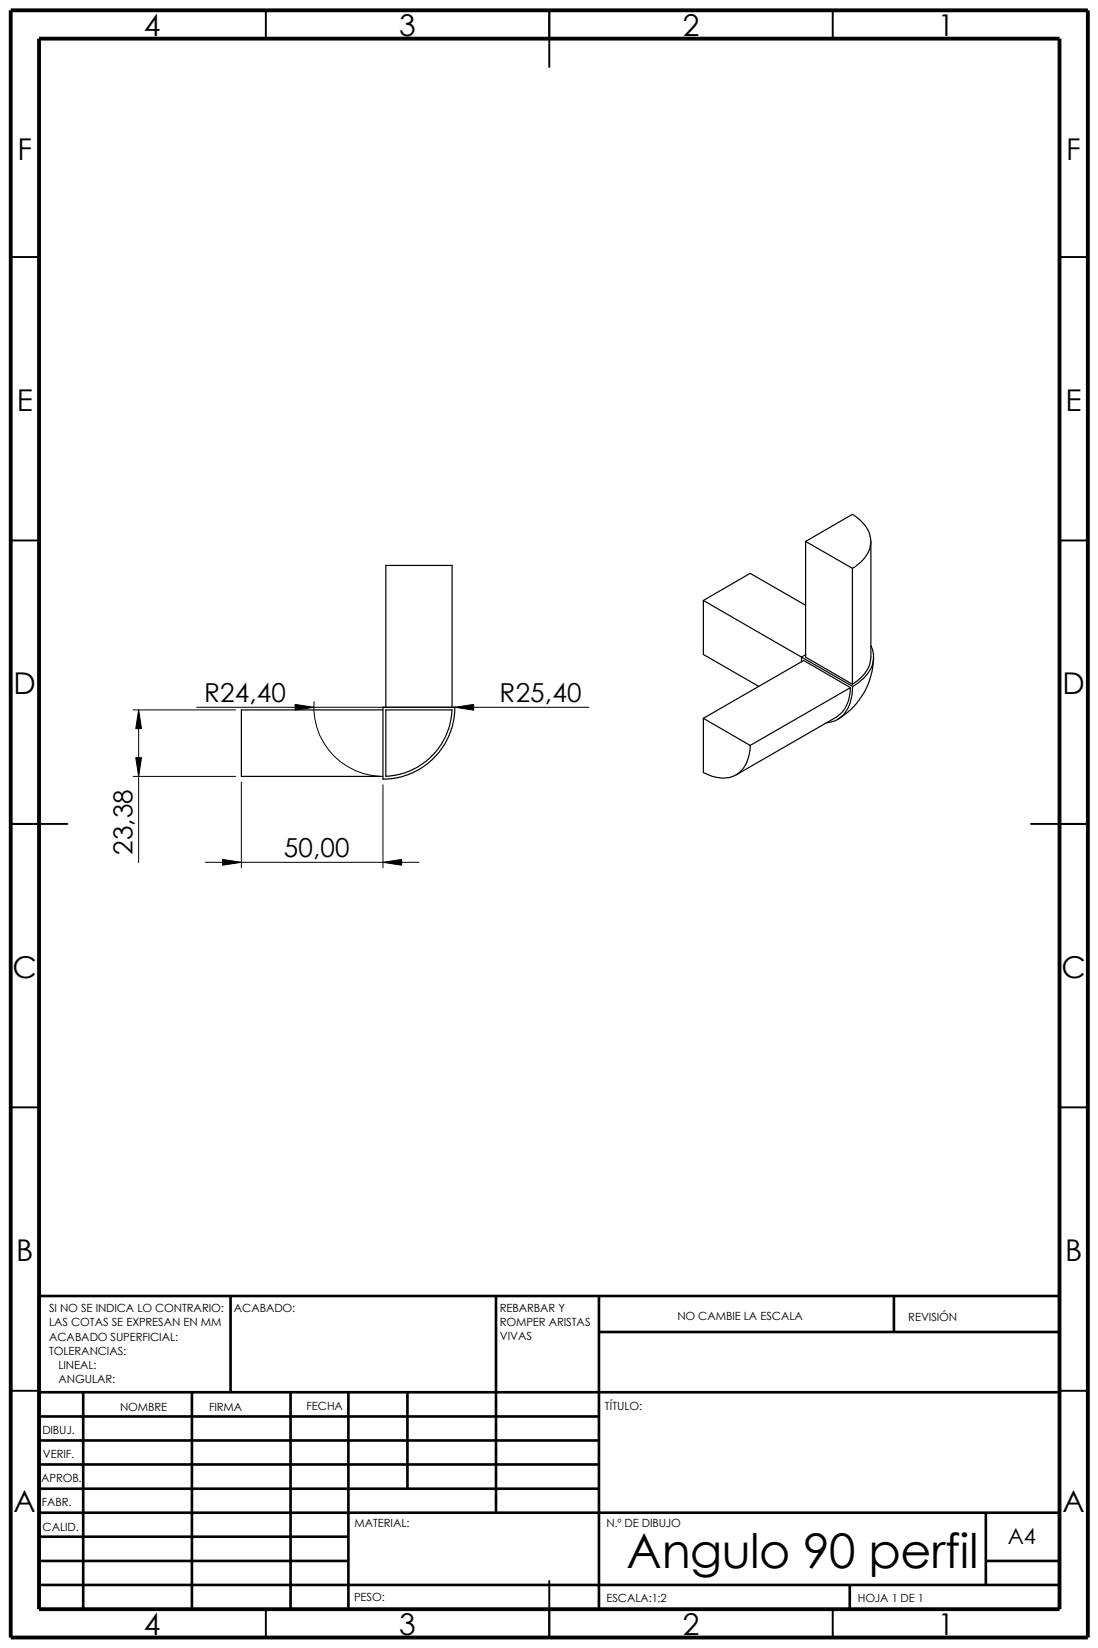
[picture p58: page 1]
ESCALA:1:2; HOJA 1 DE 1; PESO:; N.º DE DIBUJO; REVISIÓN; MATERIAL:; FABR.; CALID.; ACABADO:; VIVAS; REBARBAR Y ROMPER ARISTAS; Angulo 90 perfil

SI NO SE INDICA LO CONTRARIO:
LAS COTAS SE EXPRESAN EN MM
ACABADO SUPERFICIAL:
TOLERANCIAS:
LINEAL:
ANGULAR:

NO CAMBIE LA ESCALA

NOMBRE | FIRMA | FECHA | TÍTULO:

DIBUJ.

VERIF.

APROB.
