45duro/ProyectoBarredor/PLANOS PDF/AnguloParal - Hoja1.pdf

E E

F F

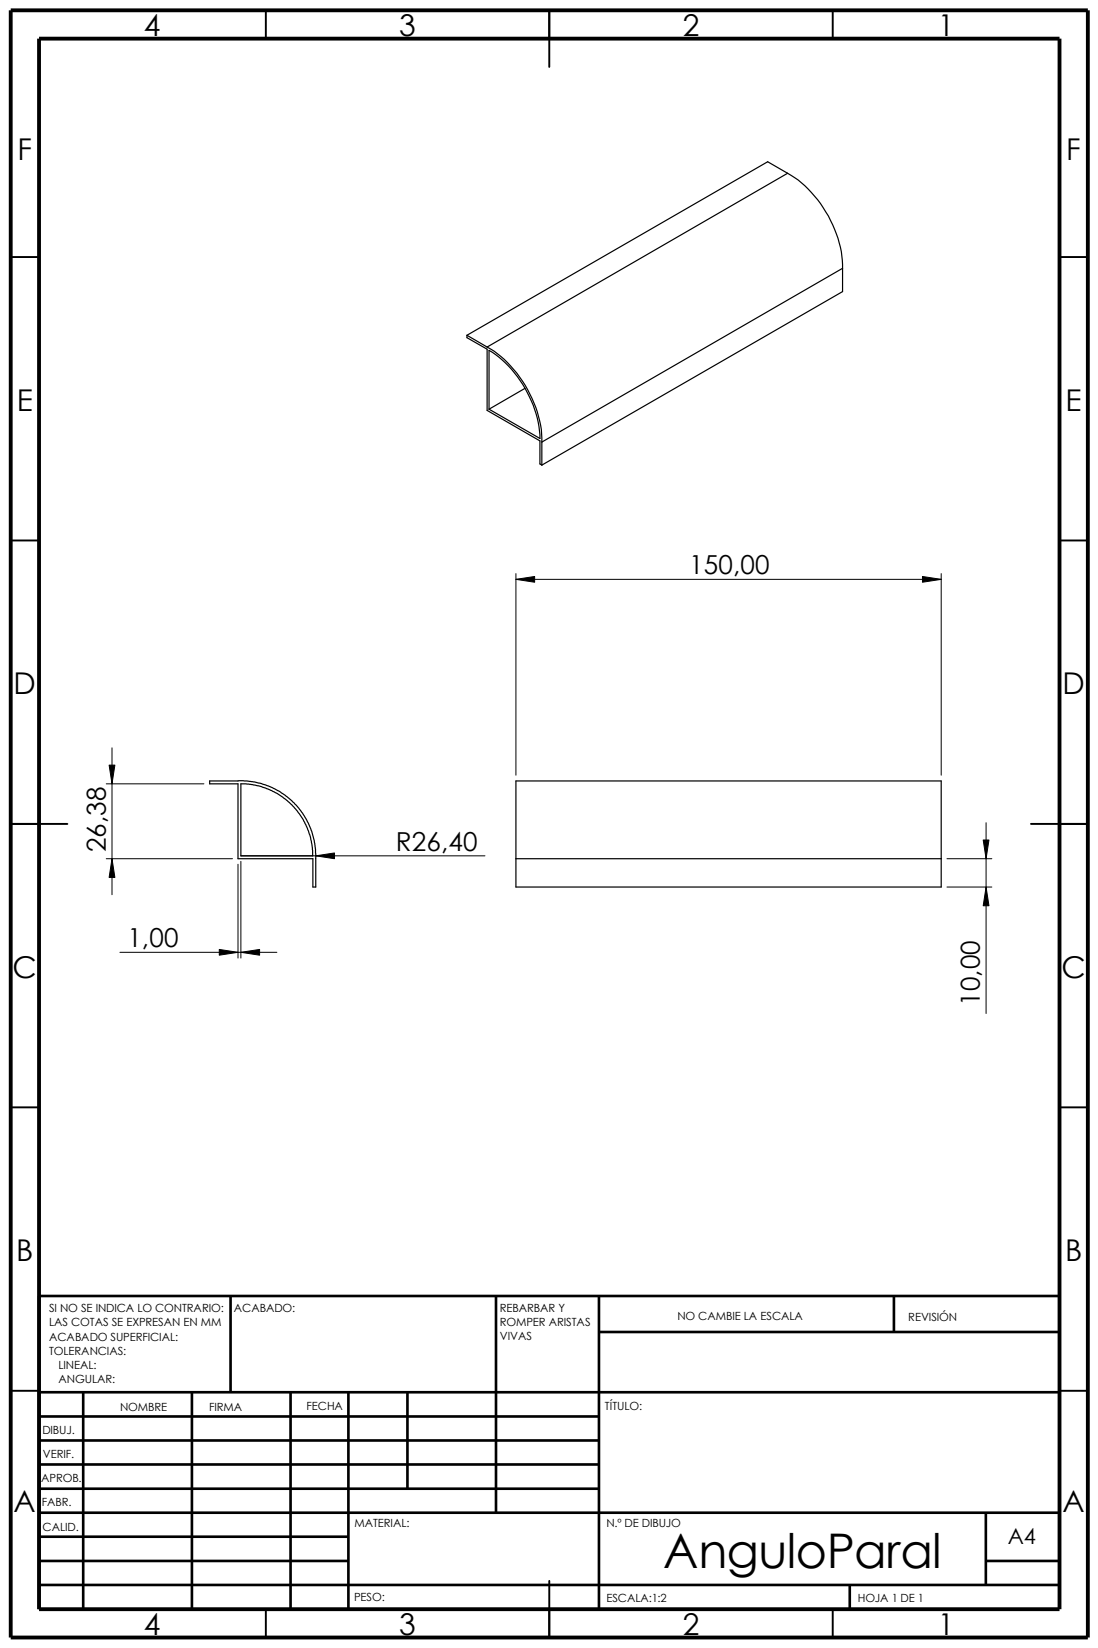
[picture p59: page 1]
PESO:; FABR.; CALID.; ESCALA:1:2; HOJA 1 DE 1; N.º DE DIBUJO; MATERIAL:; NO CAMBIE LA ESCALA; REVISIÓN SI NO SE INDICA LO CONTRARIO:; AnguloParal

LAS COTAS SE EXPRESAN EN MM ACABADO SUPERFICIAL: TOLERANCIAS: LINEAL: ANGULAR: | ACABADO: | REBARBAR Y ROMPER ARISTAS VIVAS

NOMBRE | FIRMA | FECHA | TÍTULO:

DIBUJ.

VERIF.

APROB.
