45duro/ProyectoBarredor/PLANOS PDF/Anillos Rodillo2 - Hoja1.pdf

E E

F F

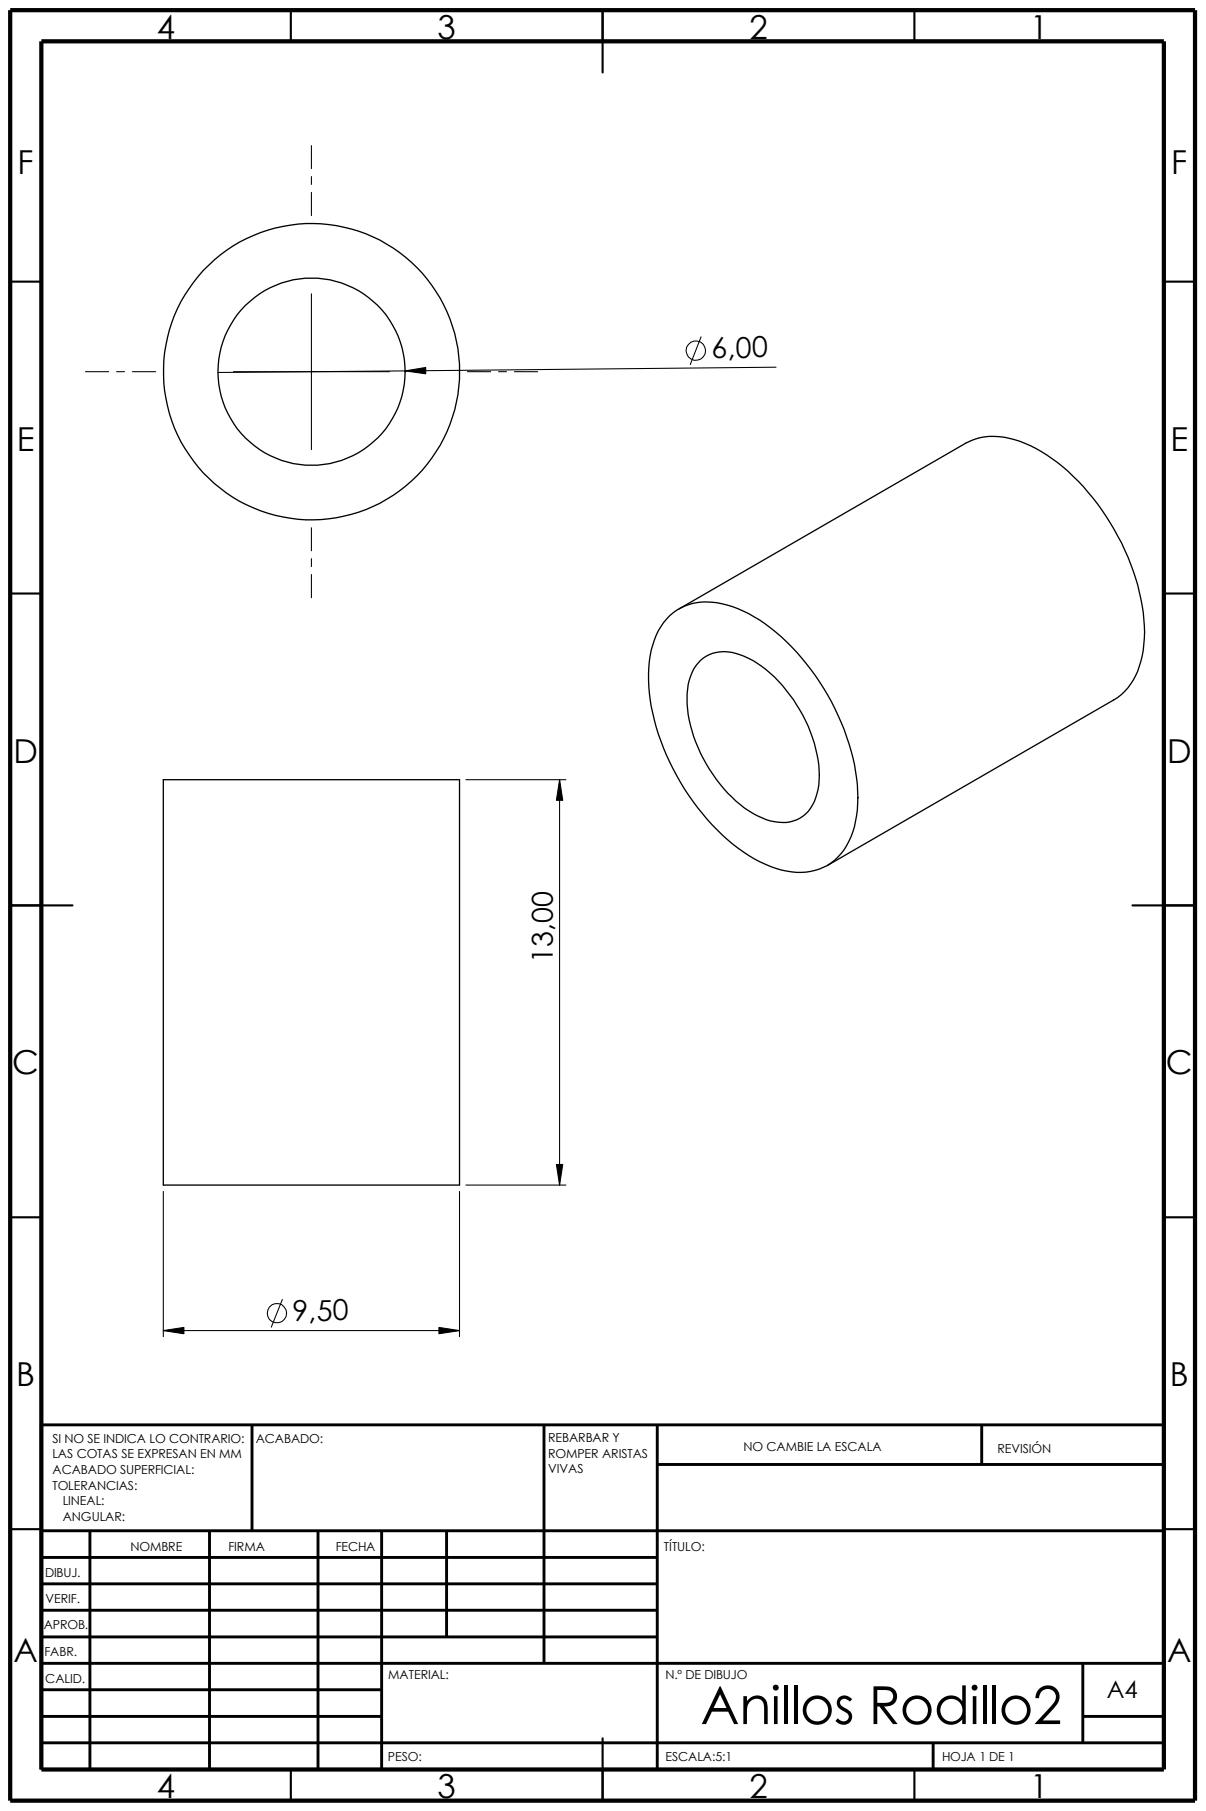
[picture p60: page 1]
PESO:; FABR.; ESCALA:5:1; N.º DE DIBUJO; HOJA 1 DE 1; REVISIÓN; CALID.; ACABADO:; VIVAS; MATERIAL:; REBARBAR Y ROMPER ARISTAS; Anillos Rodillo2

NO CAMBIE LA ESCALA SI NO SE INDICA LO CONTRARIO:
LAS COTAS SE EXPRESAN EN MM
ACABADO SUPERFICIAL:
TOLERANCIAS:
LINEAL:
ANGULAR:

NOMBRE | FIRMA | FECHA | TÍTULO:

DIBUJ.

VERIF.

APROB.
