45duro/ProyectoBarredor/PLANOS PDF/BASE OMNI.pdf

E E

F F

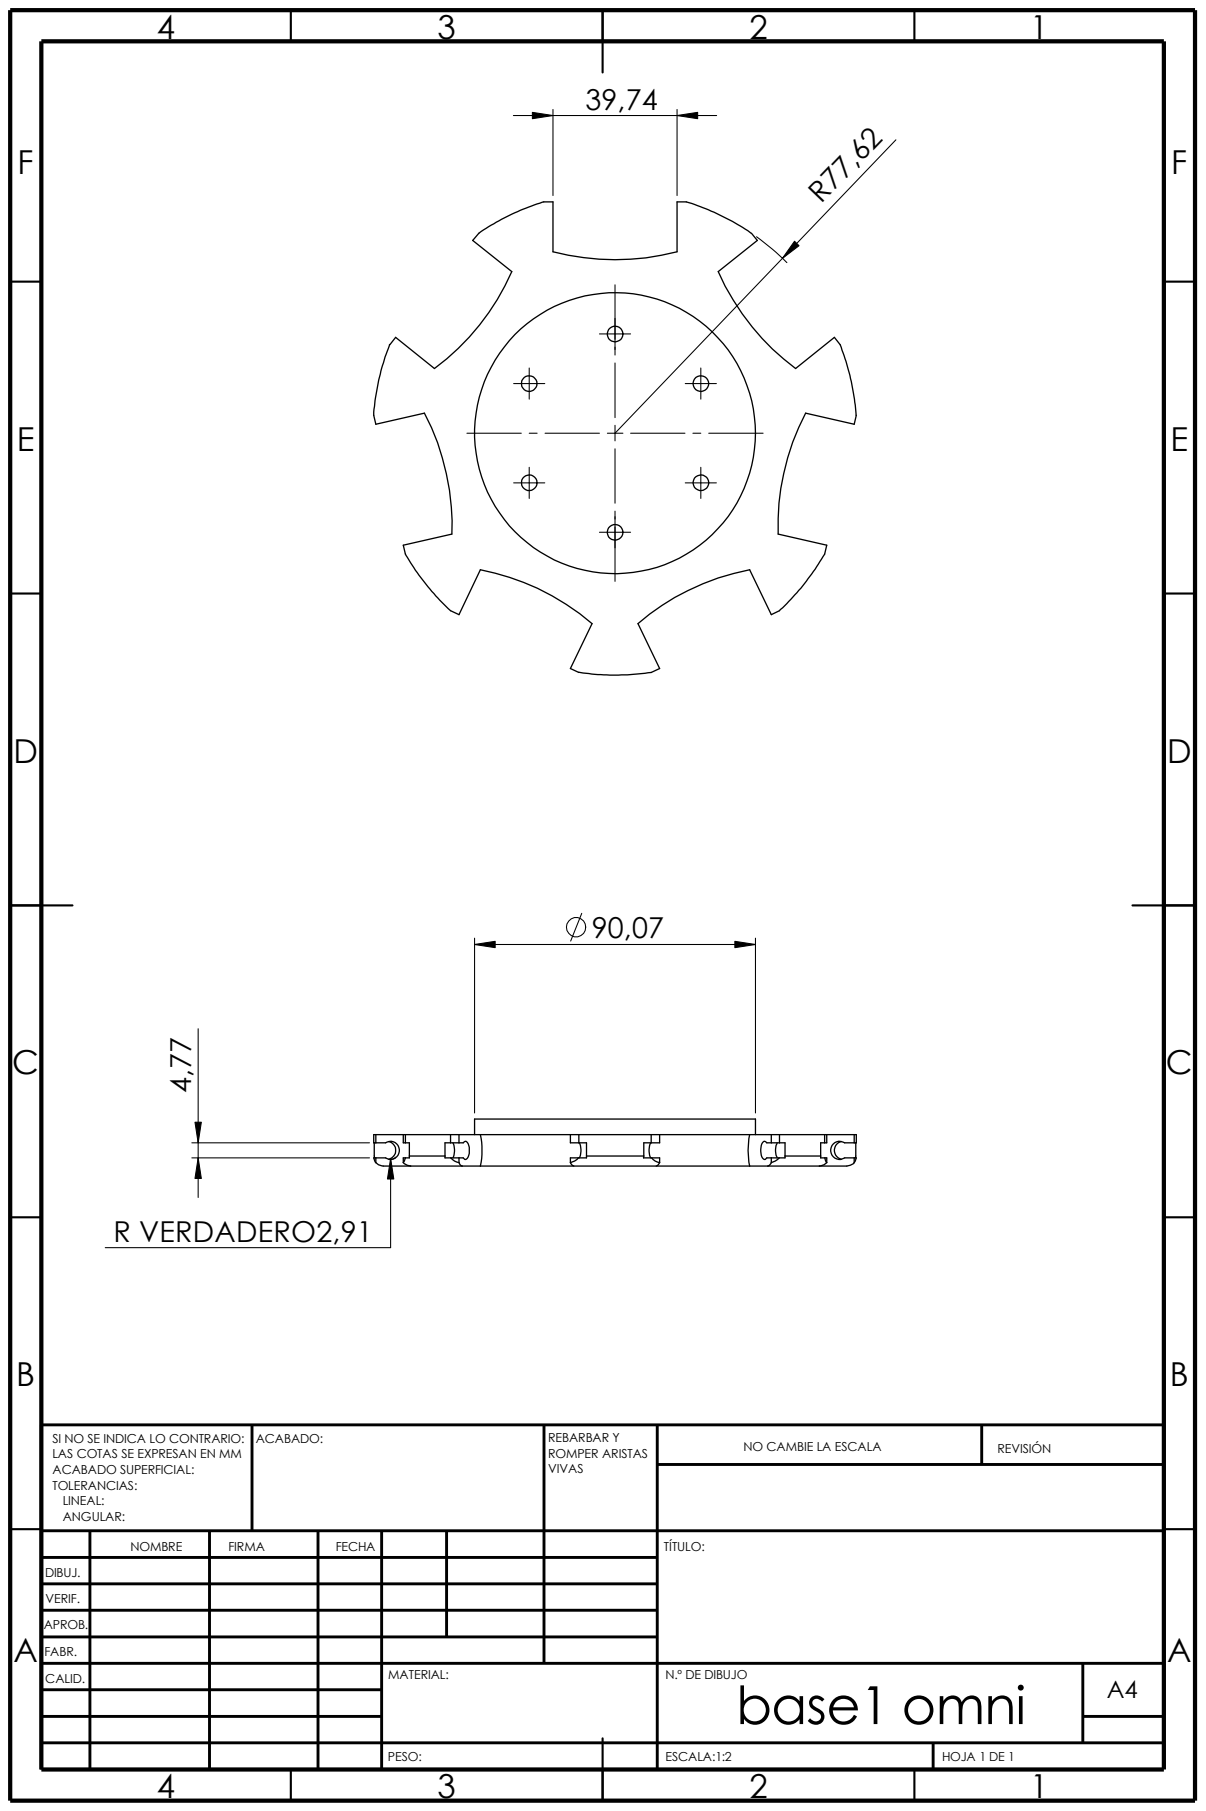
[picture p61: page 1]
HOJA 1 DE 1; PESO:; N.º DE DIBUJO; REVISIÓN; ESCALA:1:2; FABR.; CALID.; ACABADO:; VIVAS; MATERIAL:; REBARBAR Y ROMPER ARISTAS; base1 omni; R VERDADERO2,91 ⁴,77

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

NO CAMBIE LA ESCALA

NOMBRE | FIRMA | FECHA | TÍTULO:

DIBUJ.

VERIF.

APROB.
