45duro/ProyectoBarredor/PLANOS PDF/Llanta Fija - Hoja1.pdf

E E

F F

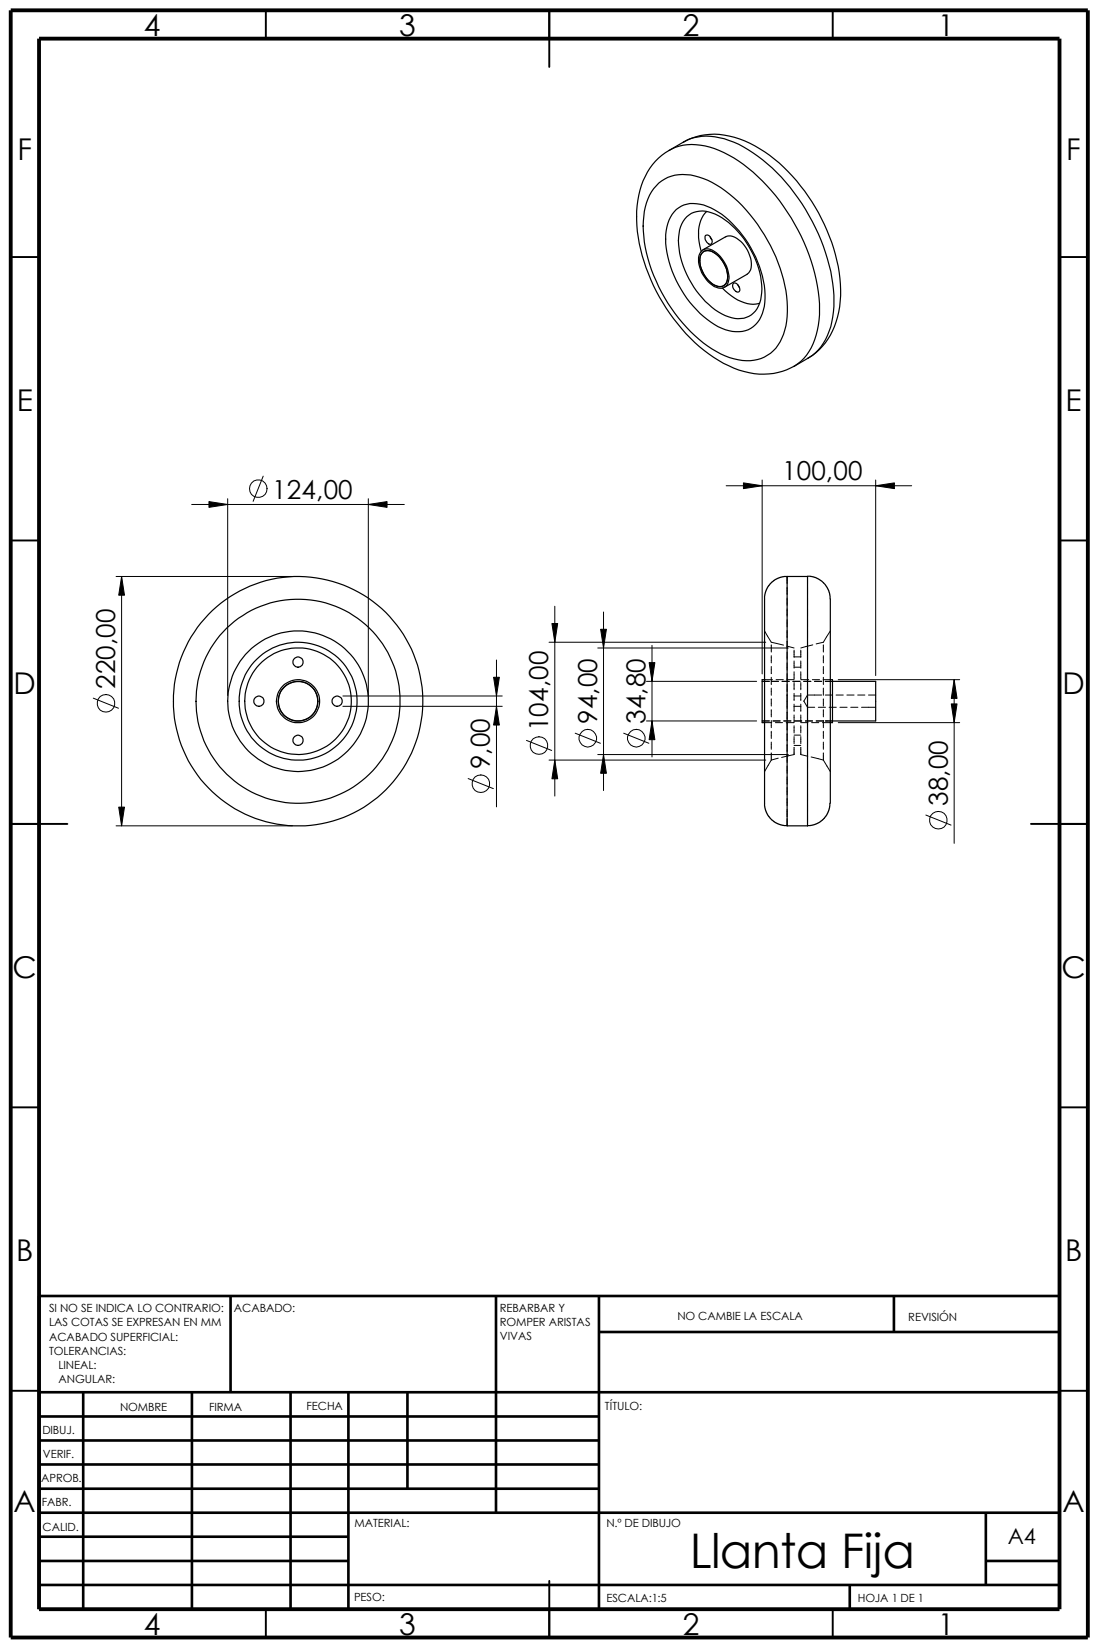
[picture p62: page 1]
PESO:; ESCALA:1:5; FABR.; HOJA 1 DE 1; N.º DE DIBUJO; REVISIÓN; CALID.; ACABADO:; VIVAS; MATERIAL:; REBARBAR Y ROMPER ARISTAS; Llanta Fija

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

NOMBRE | FIRMA | FECHA | TÍTULO:

DIBUJ.

VERIF.

APROB.
