45duro/ProyectoBarredor/PLANOS PDF/Motores Pololu - Hoja1.pdf

E E

F F

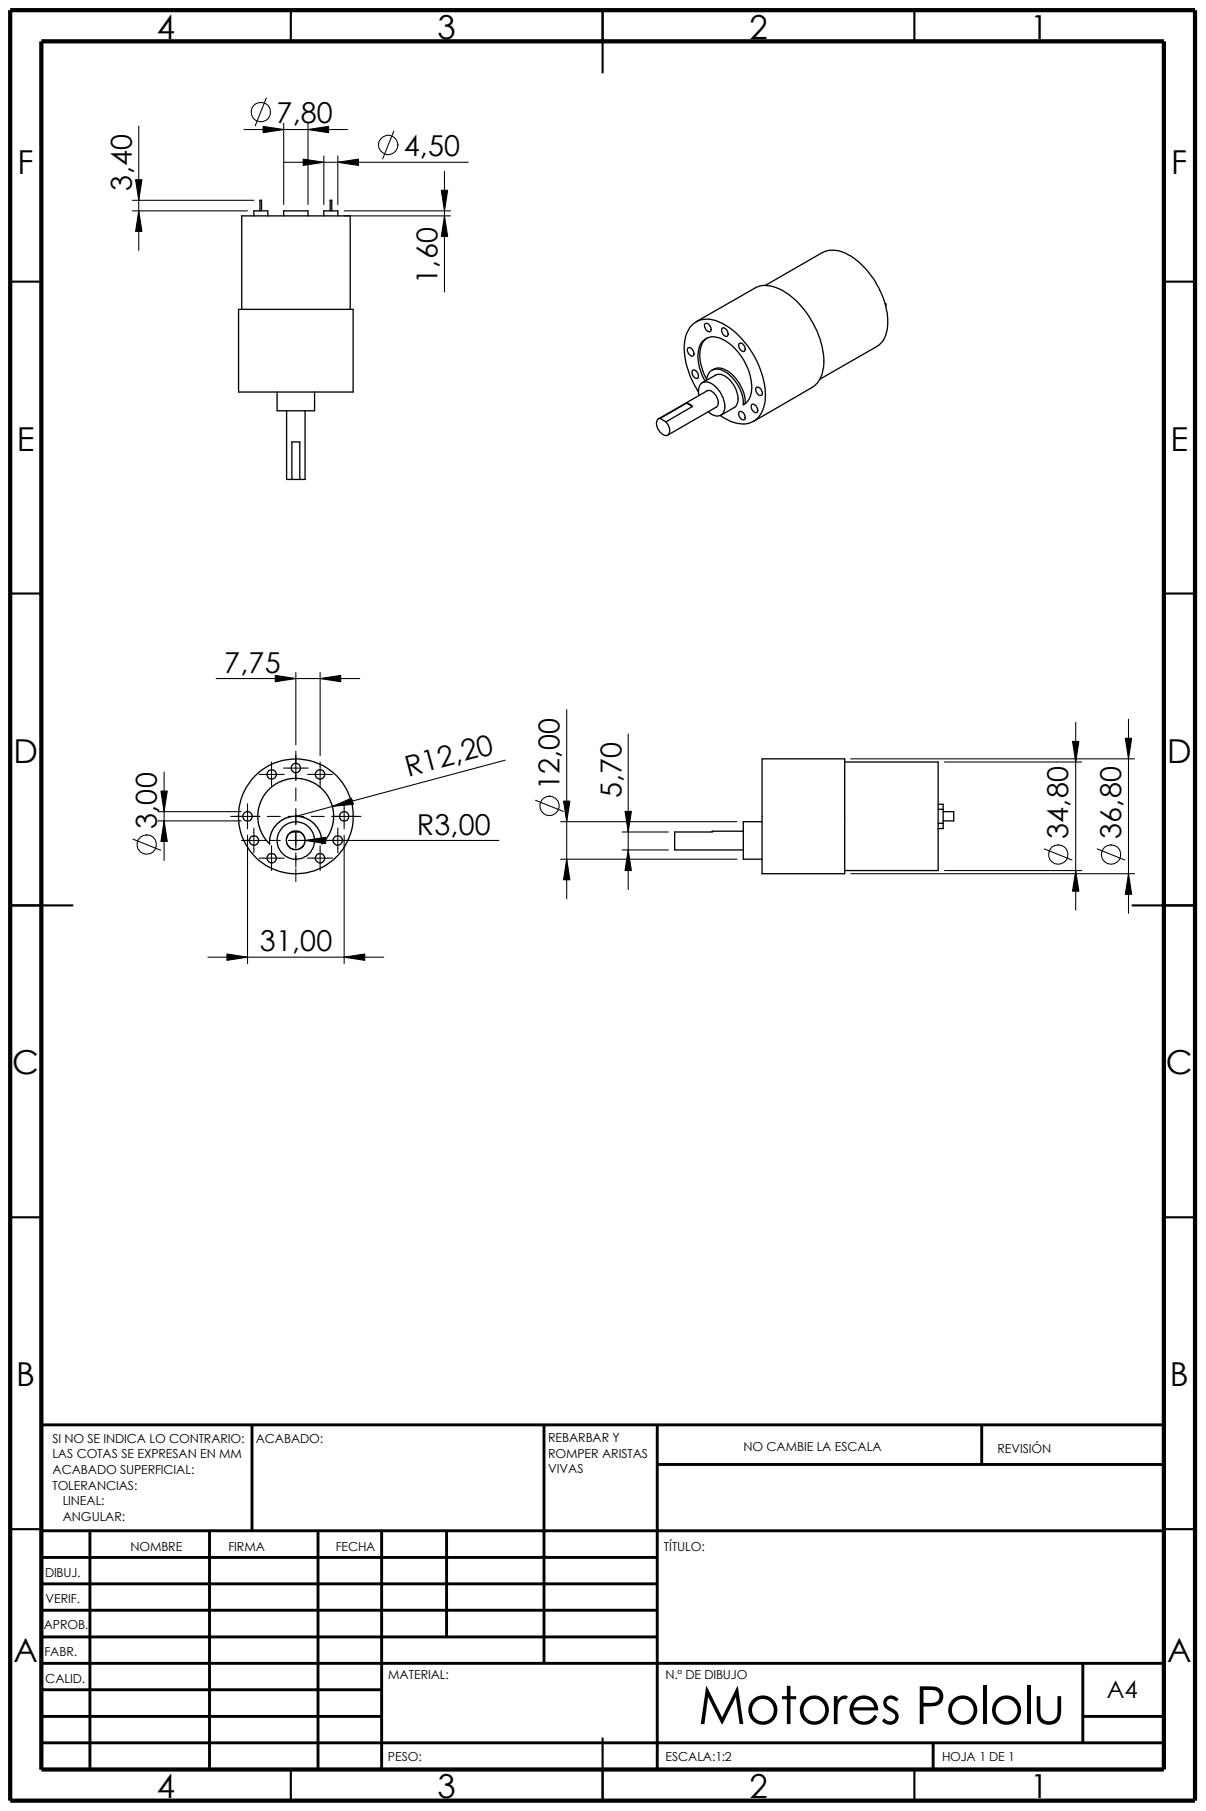
[picture p63: page 1]
PESO:; ESCALA:1:2; FABR.; HOJA 1 DE 1; N.º DE DIBUJO; REVISIÓN; CALID.; ACABADO:; VIVAS; MATERIAL:; REBARBAR Y ROMPER ARISTAS; Motores Pololu

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

NOMBRE | FIRMA | FECHA | TÍTULO:

DIBUJ.

VERIF.

APROB.
