45duro/ProyectoBarredor/PLANOS PDF/pala2 - Hoja1.pdf

E E

F F

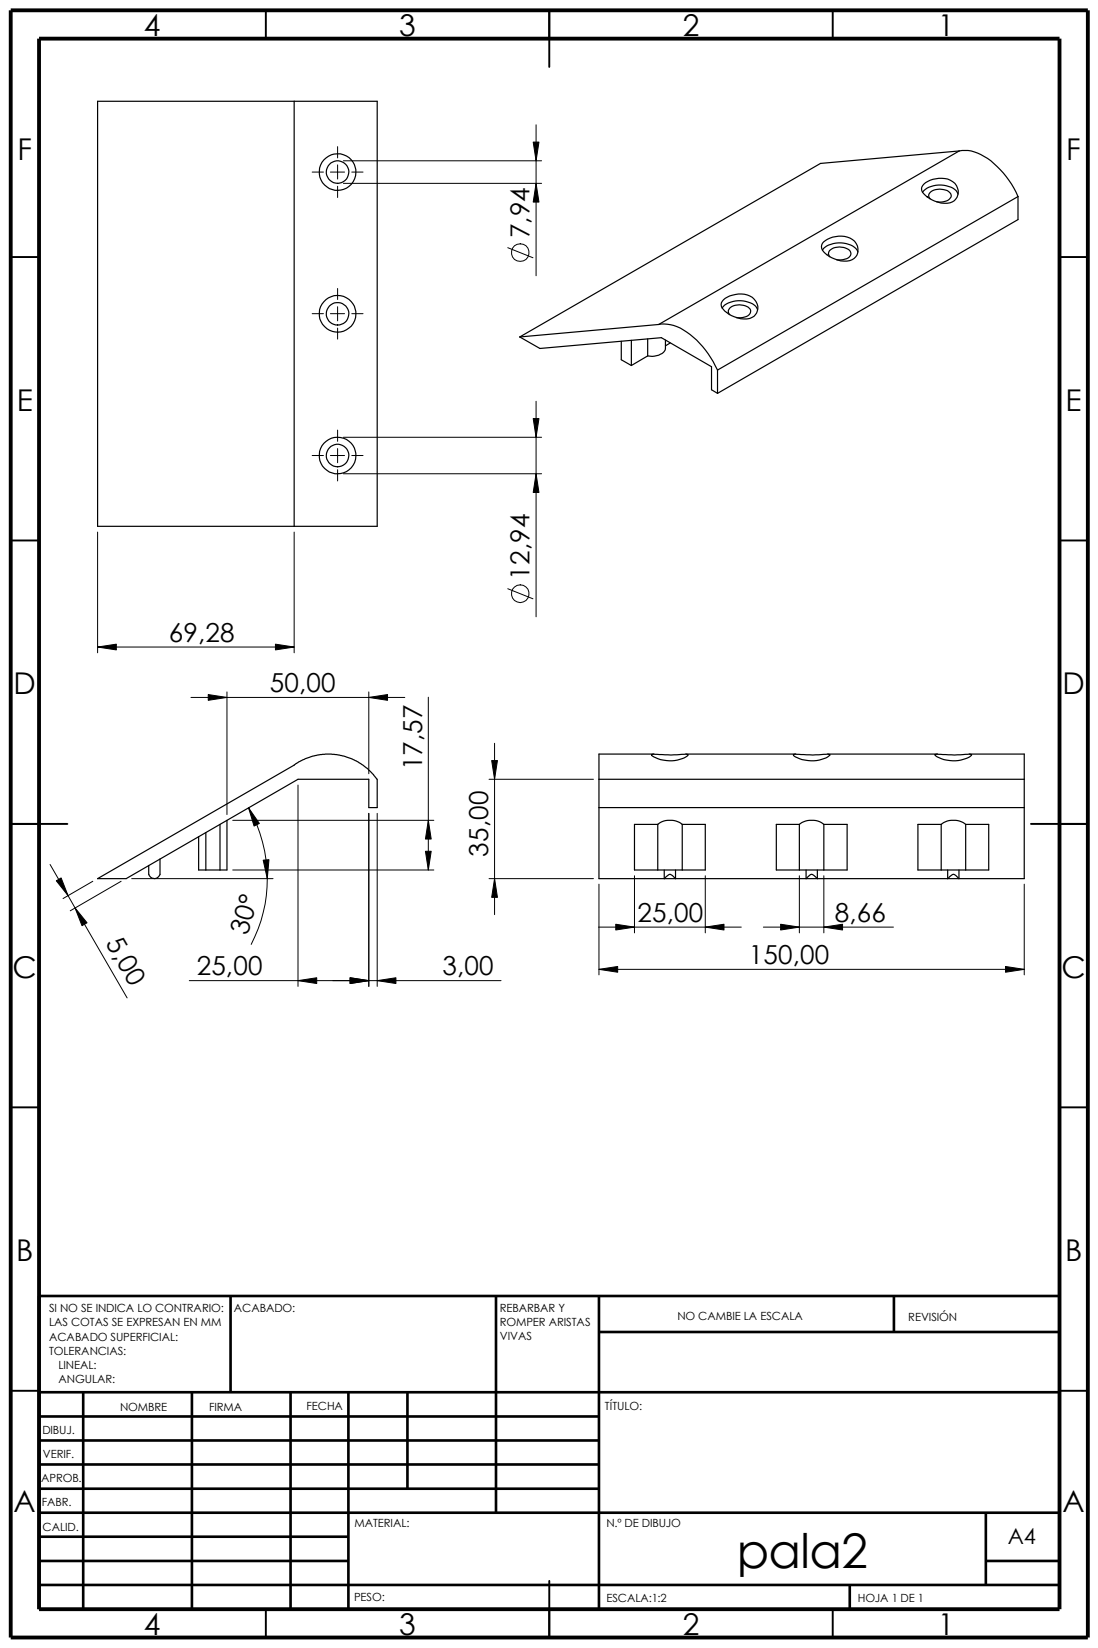
[picture p64: page 1]
HOJA 1 DE 1; PESO:; N.º DE DIBUJO; REVISIÓN; ESCALA:1:2; MATERIAL:; FABR.; CALID.; ACABADO:; VIVAS; REBARBAR Y ROMPER ARISTAS; pala2

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

NO CAMBIE LA ESCALA

NOMBRE | FIRMA | FECHA | TÍTULO:

DIBUJ.

VERIF.

APROB.
