45duro/ProyectoBarredor/PLANOS PDF/Perfil Cuadrado 15cm - Hoja1.pdf

E E

F F

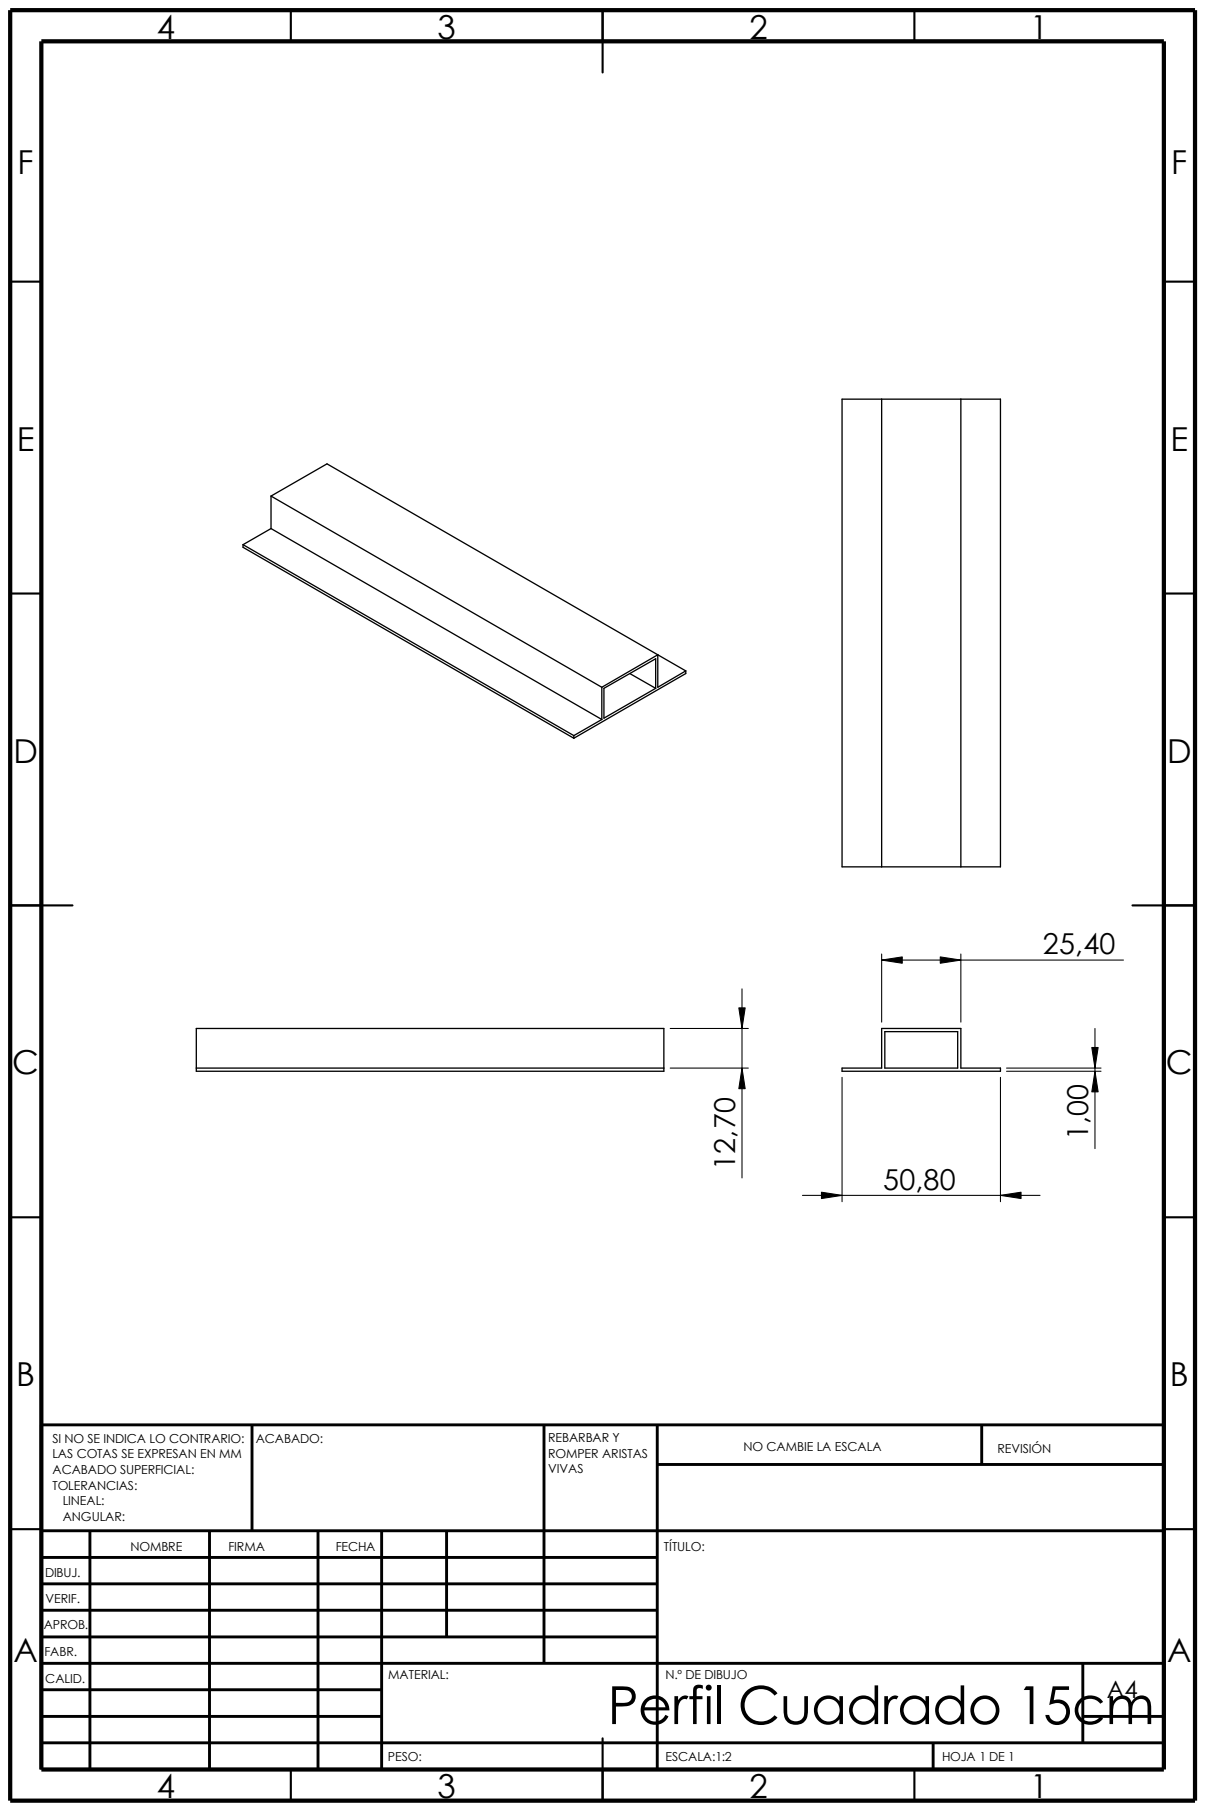
[picture p65: page 1]
FABR.; CALID.; PESO:; ESCALA:1:2; HOJA 1 DE 1; N.º DE DIBUJO; MATERIAL:; NO CAMBIE LA ESCALA; REVISIÓN SI NO SE INDICA LO CONTRARIO:; Perfil Cuadrado 15cm

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

NOMBRE | FIRMA | FECHA | TÍTULO:

DIBUJ.

VERIF.

APROB.
