45duro/ProyectoBarredor/PLANOS PDF/protecto pala - Hoja1.pdf

E E

F F

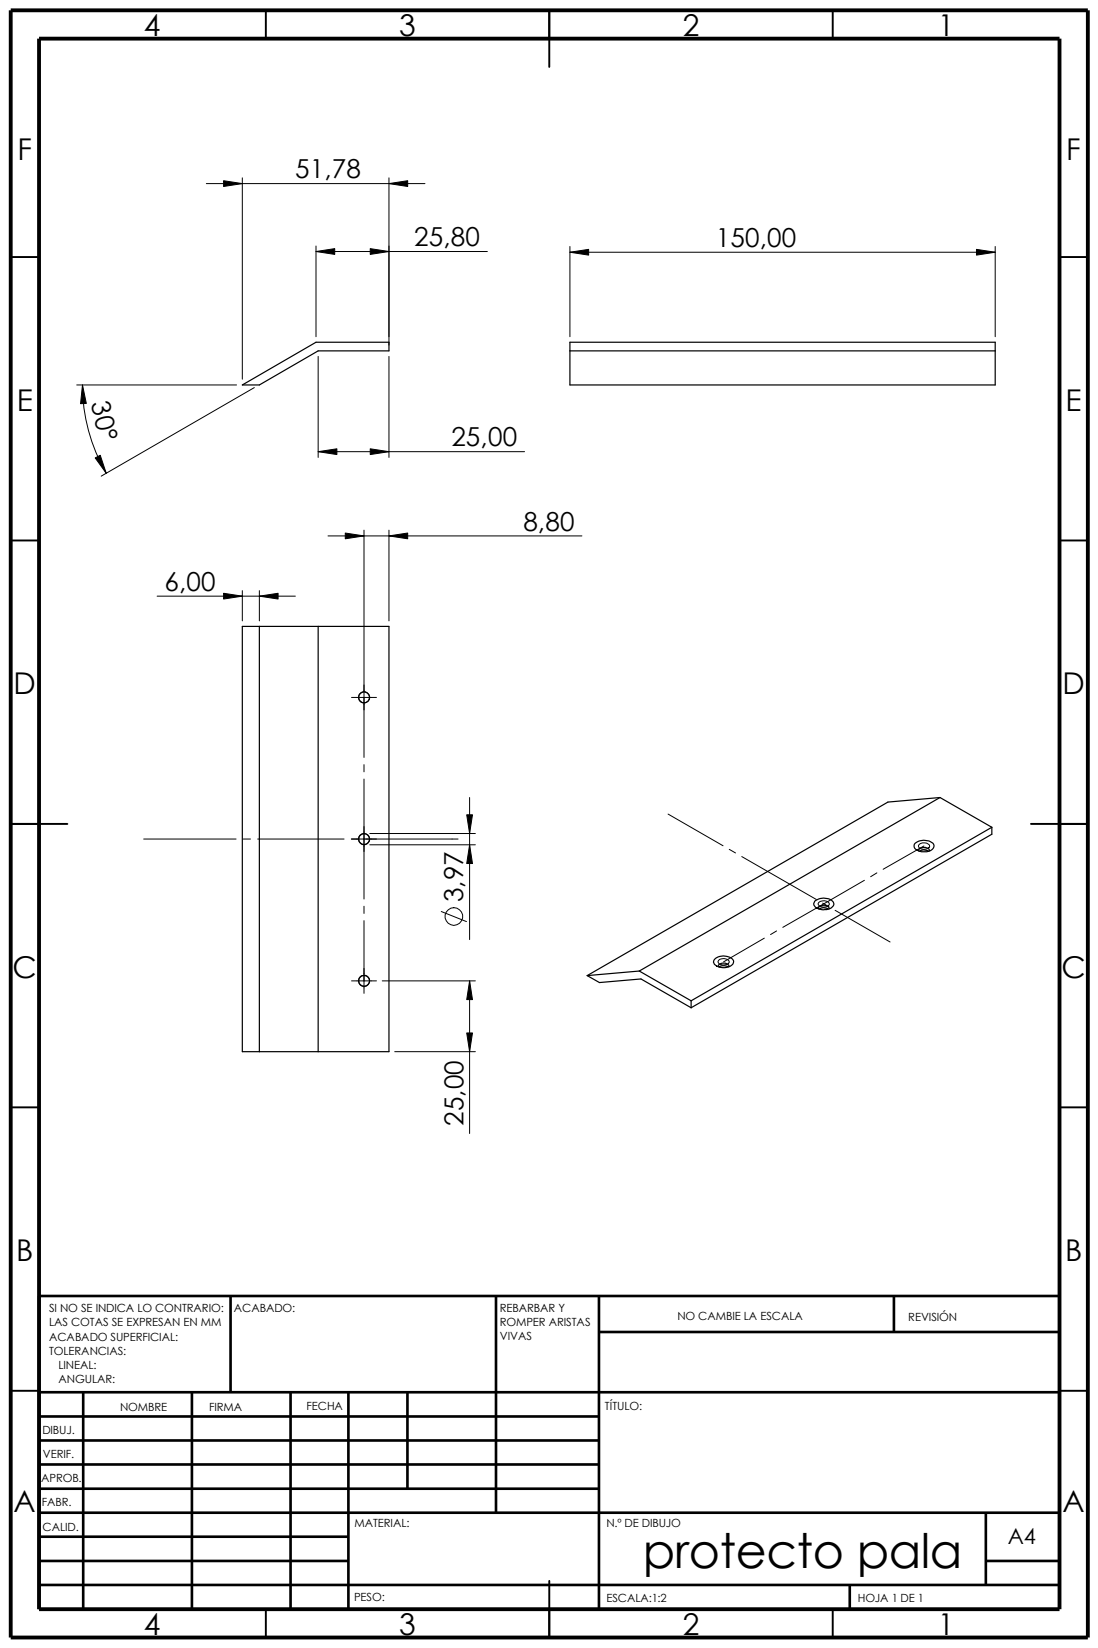
[picture p66: page 1]
ESCALA:1:2; HOJA 1 DE 1; N.º DE DIBUJO; PESO:; MATERIAL:; REVISIÓN; FABR.; CALID.; ACABADO:; VIVAS; REBARBAR Y ROMPER ARISTAS; protecto pala

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

NO CAMBIE LA ESCALA

NOMBRE | FIRMA | FECHA | TÍTULO:

DIBUJ.

VERIF.

APROB.
