45duro/ProyectoBarredor/PLANOS PDF/SOPORTE BALINERA - Hoja1.pdf

E E

F F

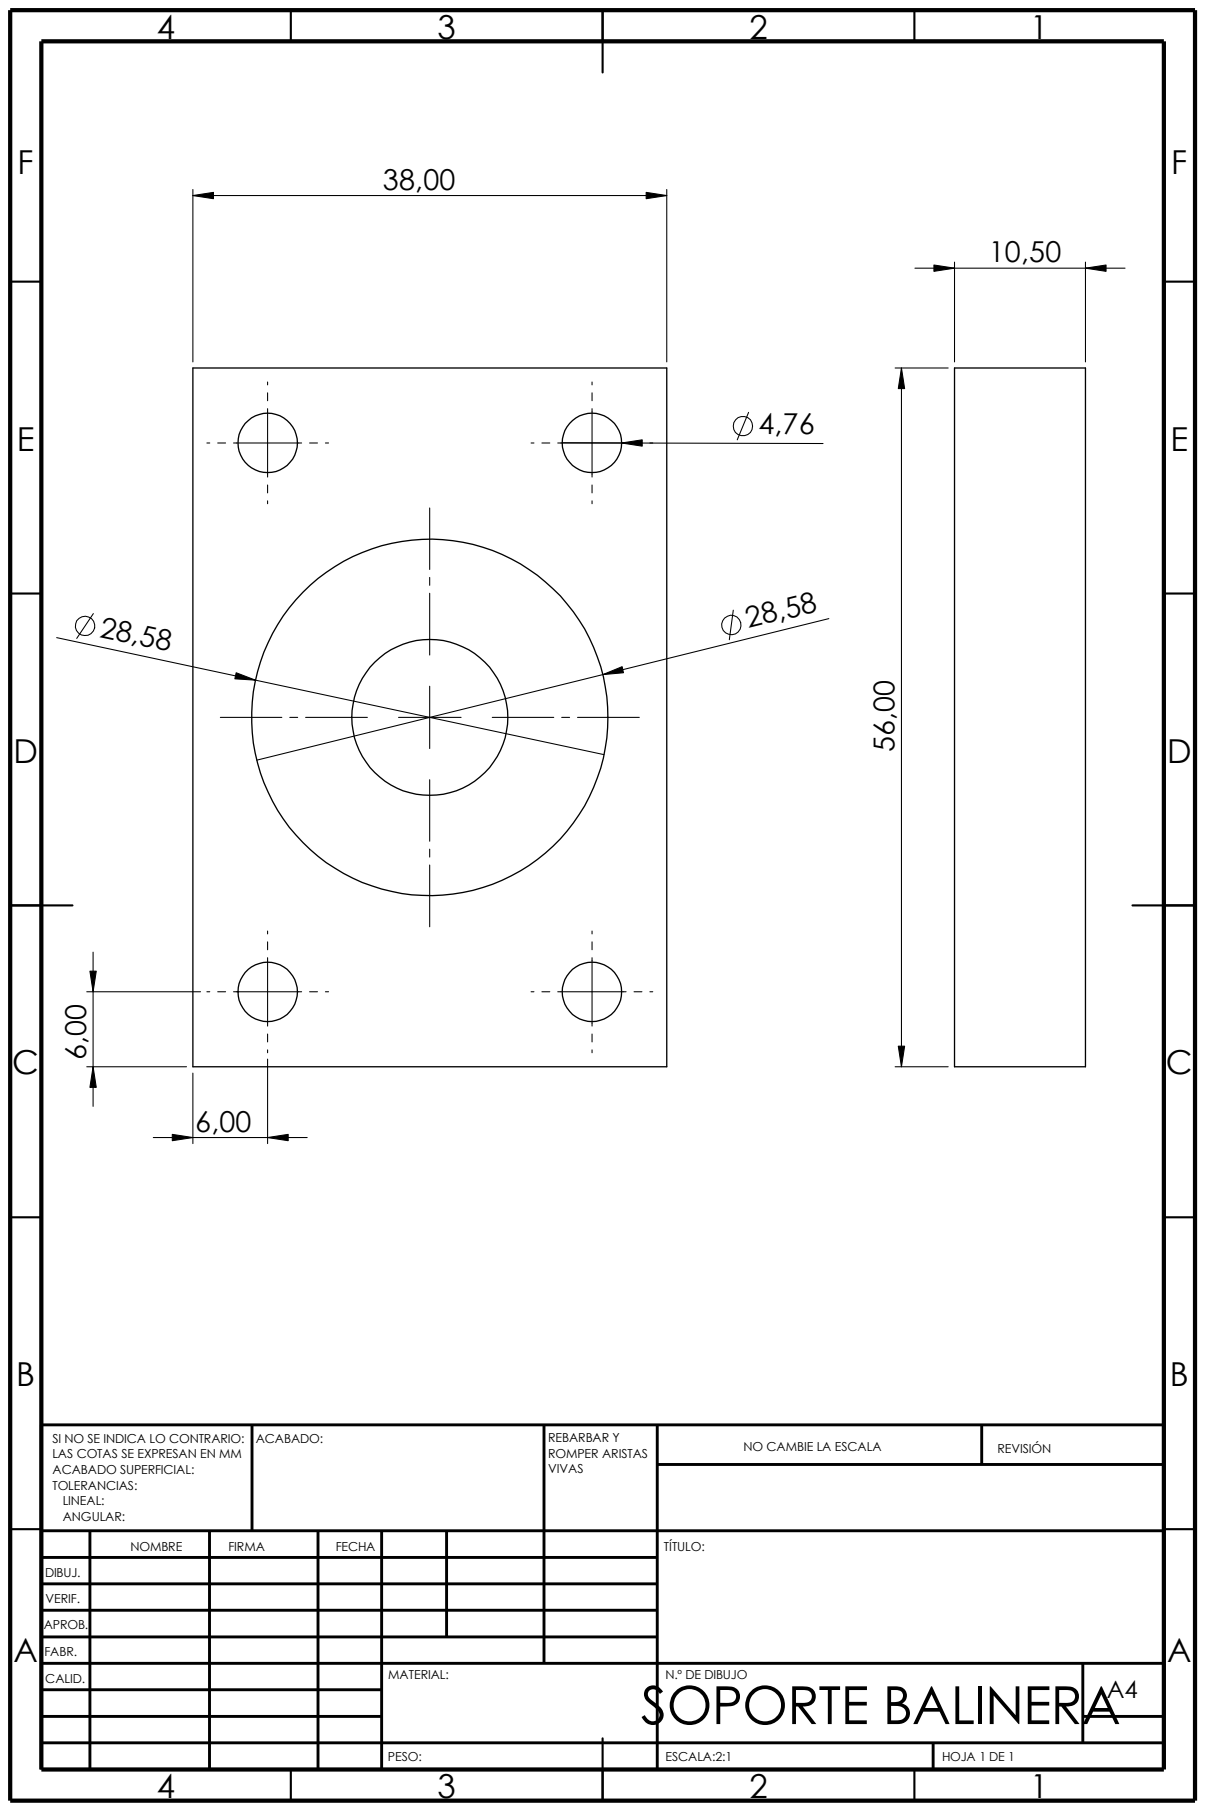
[picture p67: page 1]
ESCALA:2:1; HOJA 1 DE 1; PESO:; MATERIAL:; N.º DE DIBUJO; NO CAMBIE LA ESCALA; REVISIÓN; FABR.; CALID.; ACABADO:; VIVAS; REBARBAR Y ROMPER ARISTAS; SOPORTE BALINERA

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

NOMBRE | FIRMA | FECHA | TÍTULO:

DIBUJ.

VERIF.

APROB.
