45duro/ProyectoBarredor/PLANOS PDF/soporte en T - Hoja1.pdf

E E

F F

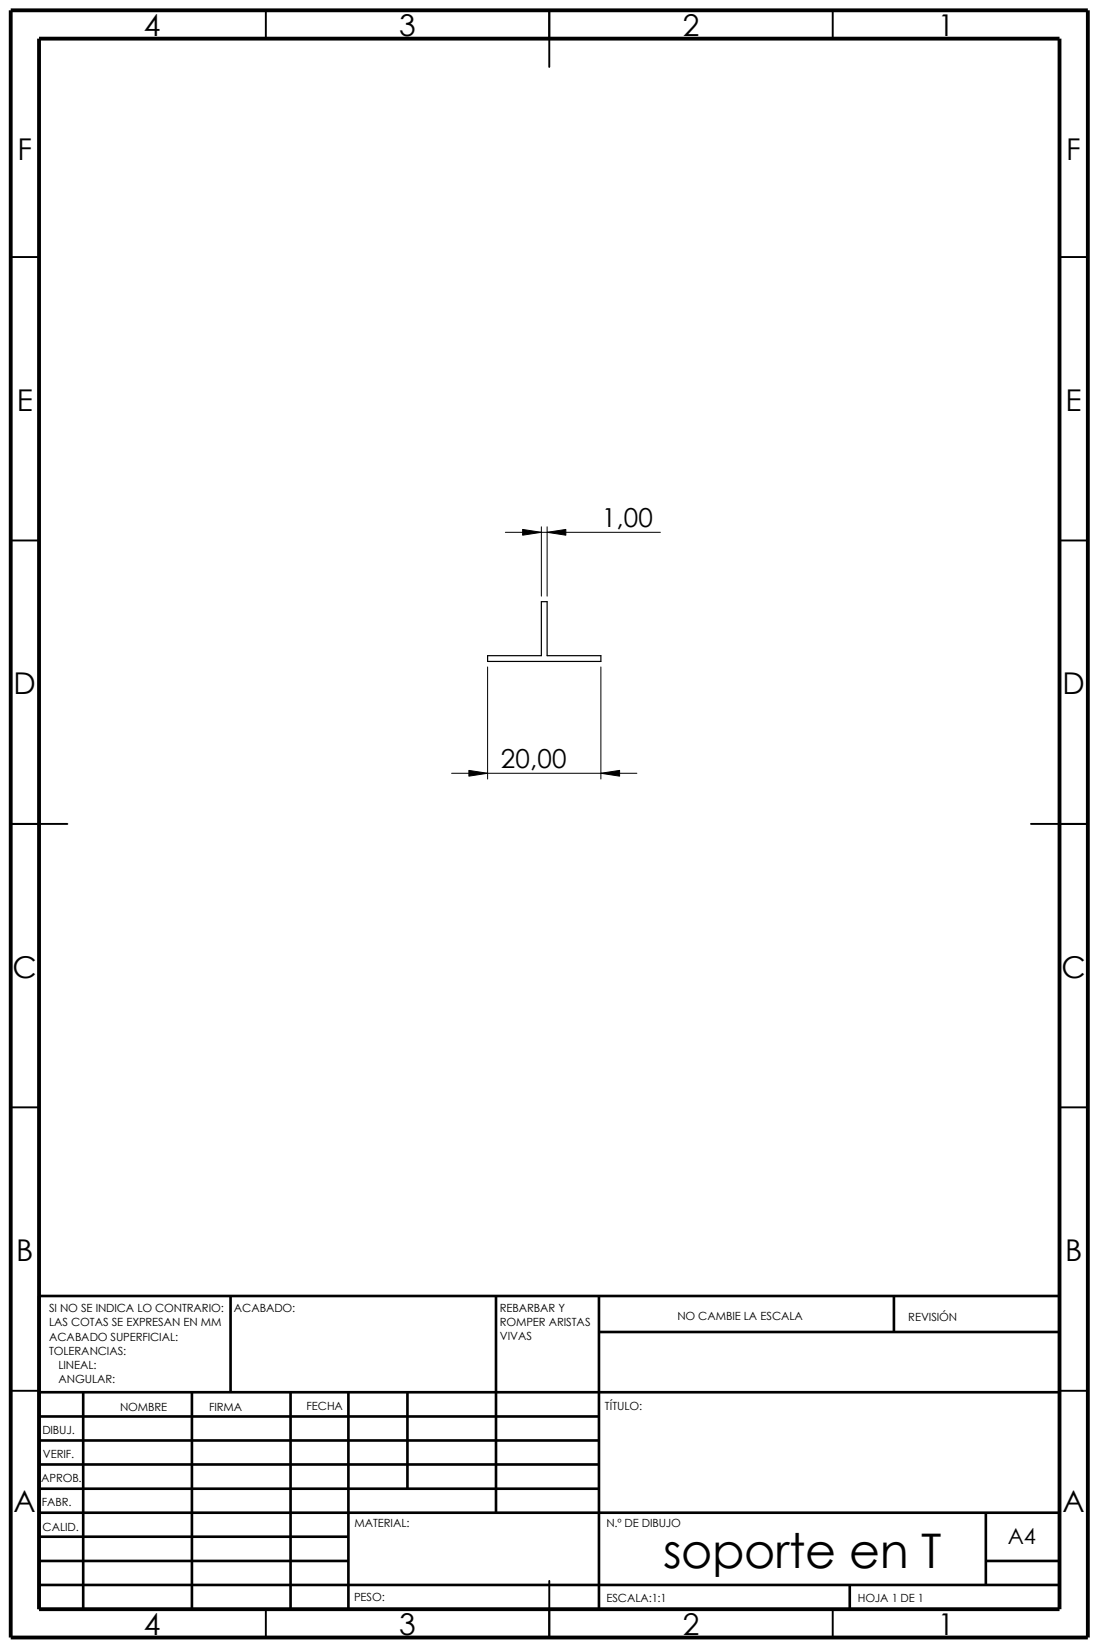
[picture p68: page 1]
PESO:; FABR.; CALID.; HOJA 1 DE 1; N.º DE DIBUJO; ESCALA:1:1; MATERIAL:; NO CAMBIE LA ESCALA; REVISIÓN SI NO SE INDICA LO CONTRARIO:; soporte en T

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

NOMBRE | FIRMA | FECHA | TÍTULO:

DIBUJ.

VERIF.

APROB.
