45duro/ProyectoBarredor/PLANOS PDF/Soporte Lateral Rodillo - Hoja1.pdf

E E

F F

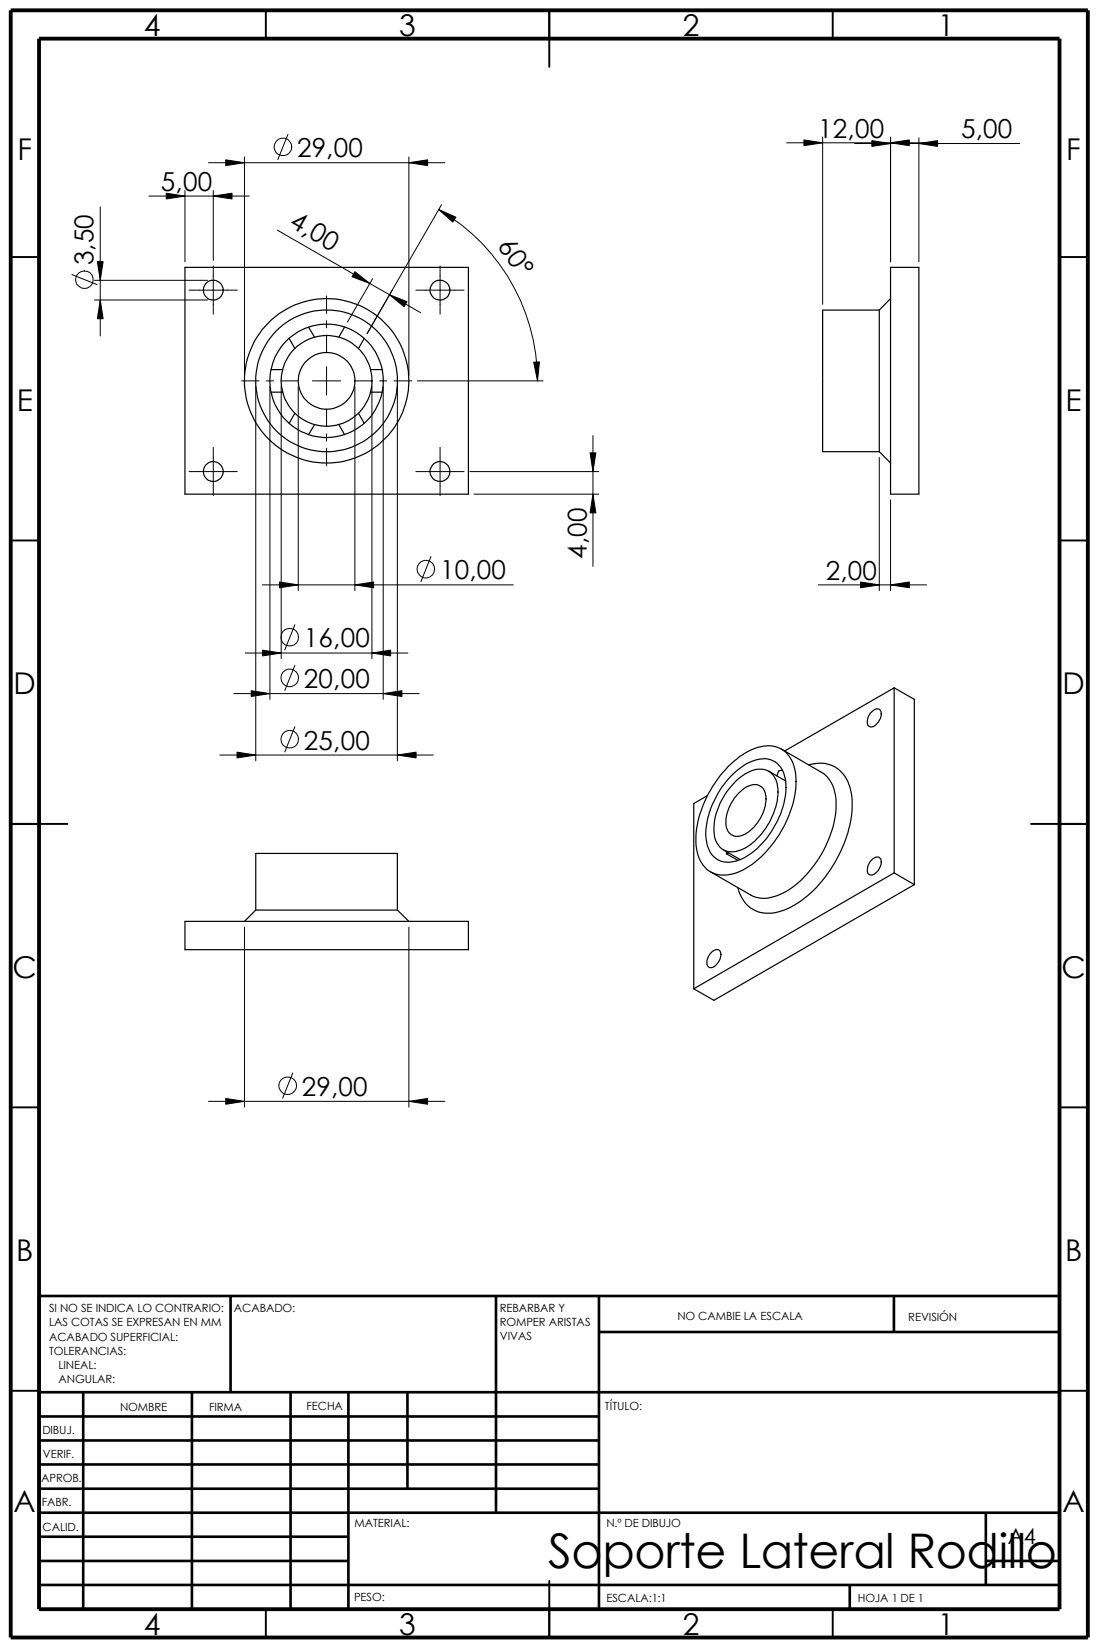
[picture p69: page 1]
PESO:; HOJA 1 DE 1; FABR.; ESCALA:1:1; REVISIÓN; CALID.; ACABADO:; VIVAS; MATERIAL:; REBARBAR Y ROMPER ARISTAS

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

NOMBRE | FIRMA | FECHA | TÍTULO:

DIBUJ.

VERIF.

APROB.

N.º DE DIBUJO
Soporte Lateral Rodillo
