45duro/ProyectoBarredor/PLANOS PDF/soporte Llantas - Hoja1.pdf

E E

F F

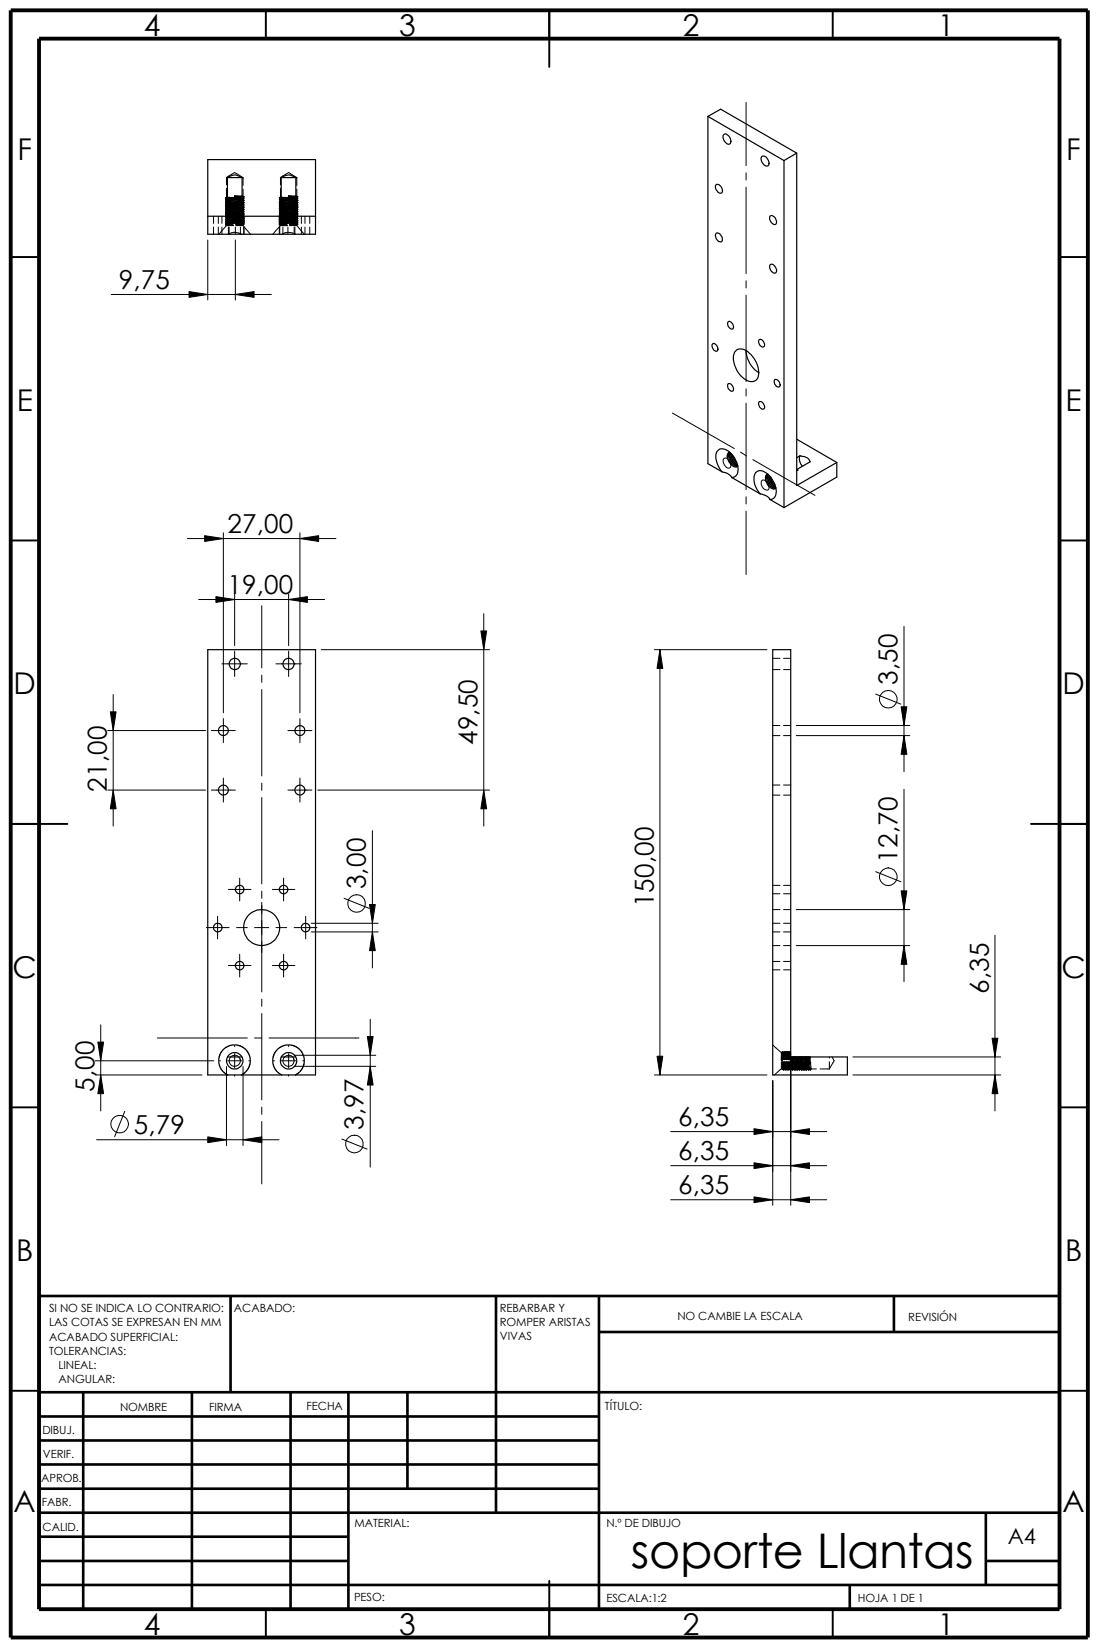
[picture p70: page 1]
PESO:; FABR.; HOJA 1 DE 1; N.º DE DIBUJO; ESCALA:1:2; REVISIÓN; CALID.; ACABADO:; VIVAS; MATERIAL:; REBARBAR Y ROMPER ARISTAS; soporte Llantas

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

NOMBRE | FIRMA | FECHA | TÍTULO:

DIBUJ.

VERIF.

APROB.
