45duro/ProyectoBarredor/PLANOS PDF/tambor - Hoja1.pdf

E E

F F

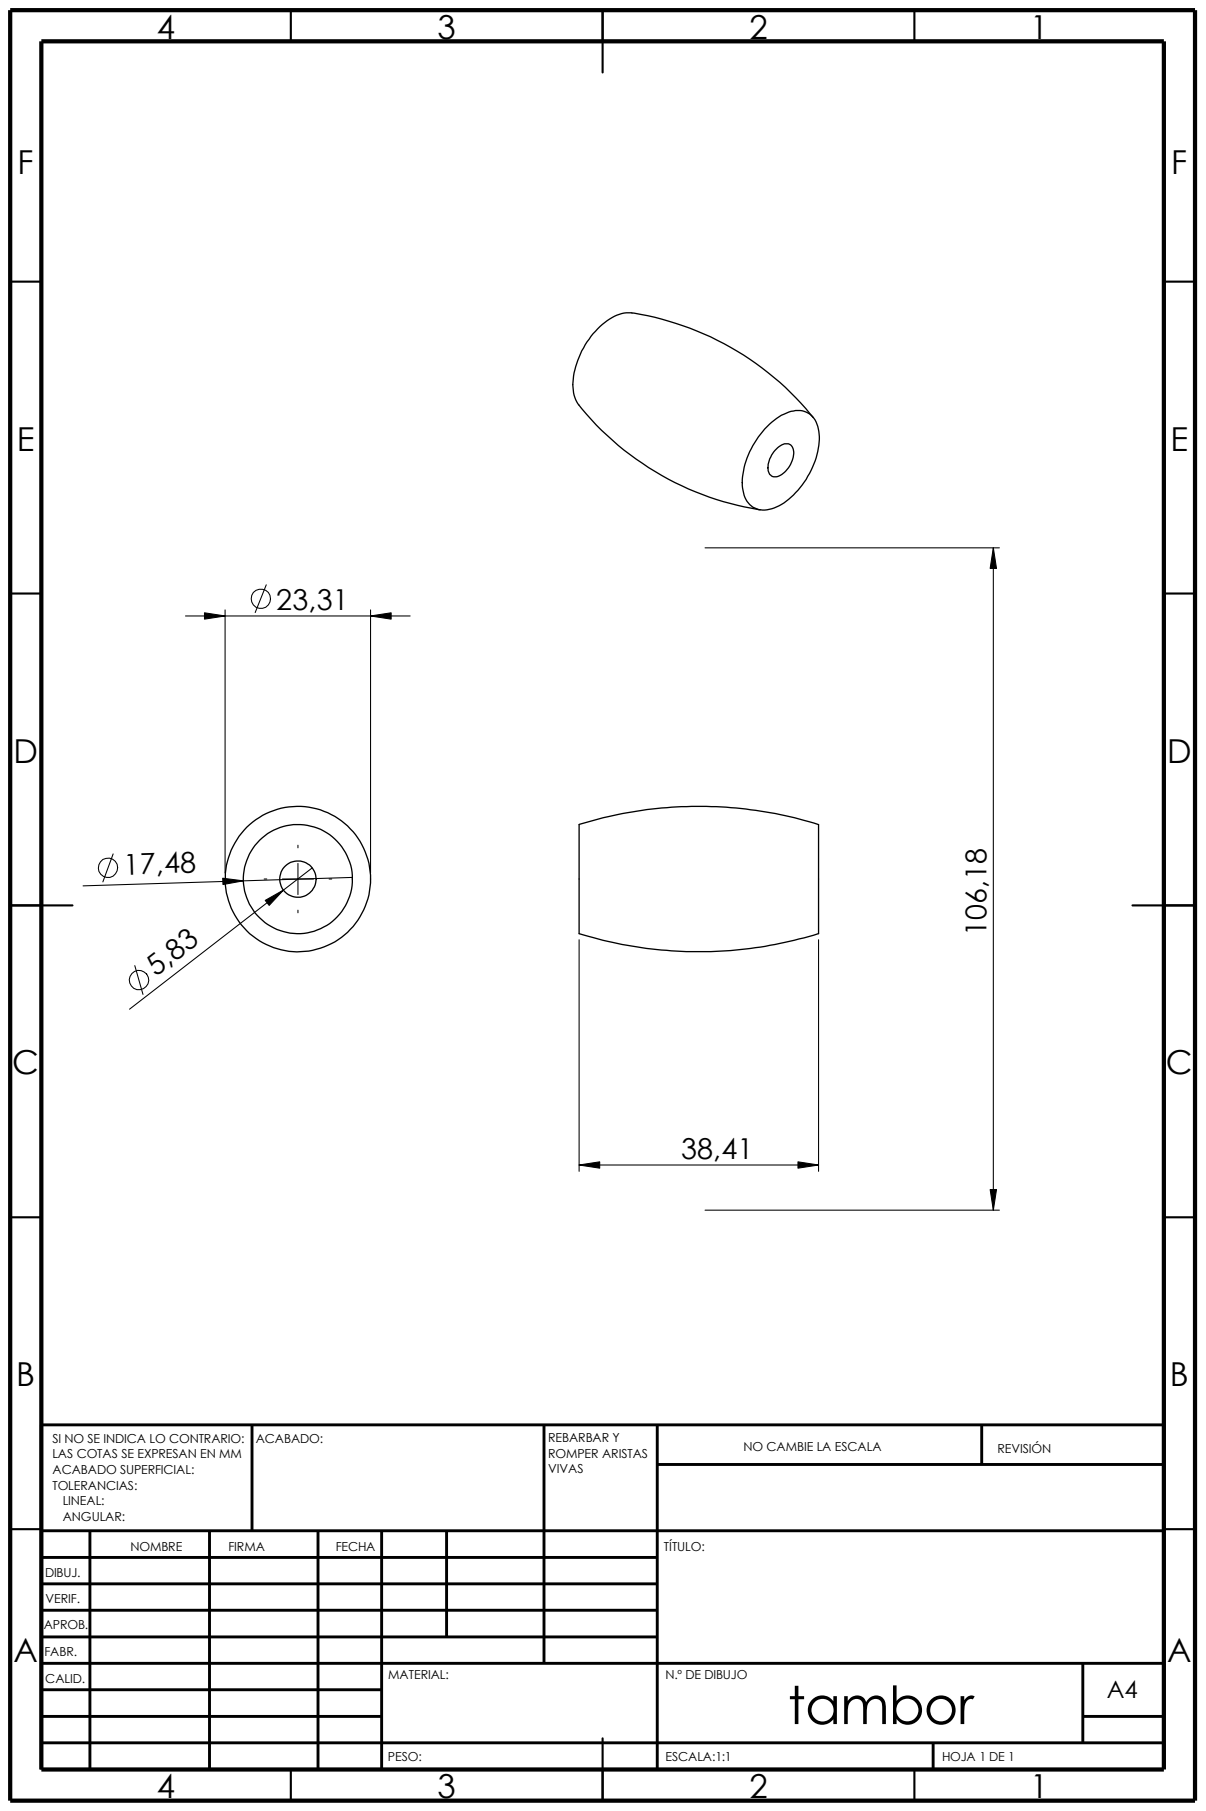
[picture p71: page 1]
REVISIÓN; N.º DE DIBUJO; ESCALA:1:1; HOJA 1 DE 1; PESO:; MATERIAL:; FABR.; CALID.; ACABADO:; VIVAS; REBARBAR Y ROMPER ARISTAS; tambor ¹⁰⁶,18

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

NO CAMBIE LA ESCALA

NOMBRE | FIRMA | FECHA | TÍTULO:

DIBUJ.

VERIF.

APROB.
