45duro/ProyectoBarredor/PLANOS PDF/AdaptadorM2R.pdf

E E

F F

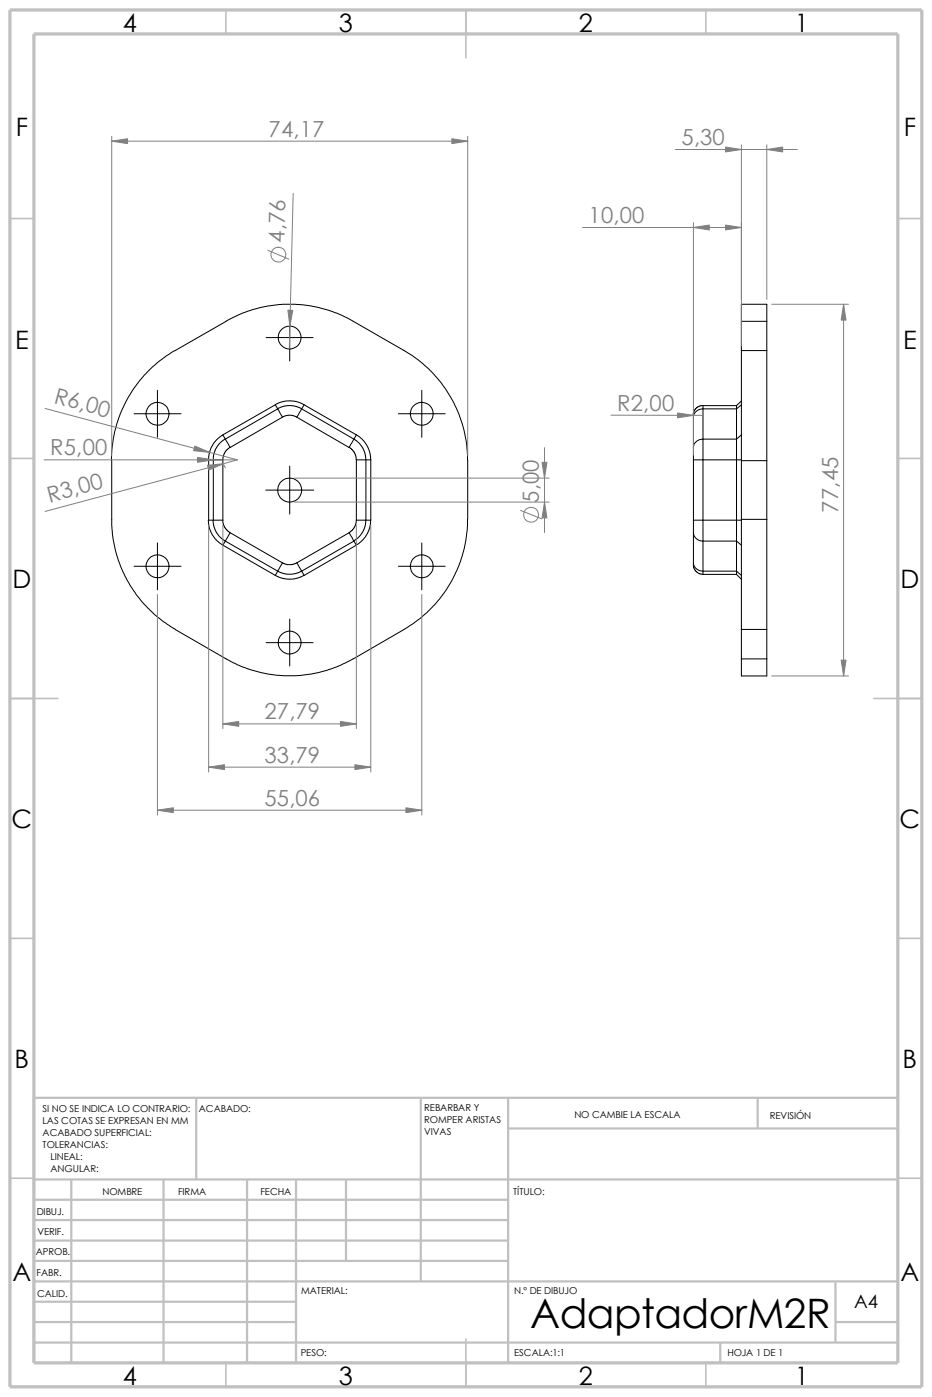
[picture p72: page 1]
N.º DE DIBUJO; ESCALA:1:1; HOJA 1 DE 1; PESO:; MATERIAL:; REVISIÓN; FABR.; CALID.; ACABADO:; VIVAS; REBARBAR Y ROMPER ARISTAS; AdaptadorM2R

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

NO CAMBIE LA ESCALA

NOMBRE | FIRMA | FECHA | TÍTULO:

DIBUJ.
VERIF.
APROB.
