45duro/ProyectoBarredor/(commit log)

2019-07-26 Pala dos hecha
    [Angulo 90 perfil.SLDPRT, Angulo.SLDPRT, AnguloFrontal.SLDPRT, AnguloParal.SLDPRT, Angulos.SLDPRT, Cepillo.SLDPRT, Chasis.SLDASM, ChasisConBasesMotor.SLDASM]
2019-07-26 Pala dos hecha con mordazas
    [pala2.SLDPRT]
2019-07-26 Pala dos hecha con mordazas y perforaciones del soporte
    [pala2.SLDPRT]
2019-07-27 Proyecto barredor con pala ensamblada, defectos en la relacion de union con cinta
    [ChasisConBasesMotor.SLDASM, protecto pala.SLDPRT]
2019-07-27 publicando con git
    [AdaptadorM2R.SLDPRT, AdaptadorM2R.STL, Assem2.SLDASM, OmniRueda.SLDASM, Pala Final.SLDASM, Part1.SLDPRT, Rueda Doble Emsablada.SLDASM, SoportePala.SLDASM]
2019-08-01 Edito el mr2 para la rueda omni y fijarlo al piso
    [AdaptadorM2R.STL, AdaptadorM3R.SLDPRT, AdaptadorM3R.STL, Anillos Rodillo.SLDPRT, Anillos Rodillo.STL, Anillos Rodillo2.SLDPRT, Anillos Rodillo2.STL, Cepillo Completo.SLDASM]
2019-08-15 Evance con transmision aun no terminado
    [Eje Tornillo.SLDPRT, Ensamblaje transmision.SLDASM, ISO - Straight bevel pinion 1M12PT 12GT 20PA 5FW ---12O15H10MD6.0N.sldprt, Motores Pololu.SLDPRT, SOPORTE BALINERA.SLDPRT, Soporte Base Motor.SLDPRT, engrane conico espiral z67.SLDPRT, pinion Transmisor.sldprt]
2019-08-16 se crean los piñones de engranaje para el sistema
    [Ensamblaje transmision.SLDASM, caja transmision.SLDPRT, prueba de nueva Transmision.SLDASM]
2019-08-24 Realizando la parte de control
    [Cepillo Completo.SLDASM, EnsamblajeChasisLlantas.SLDASM, EnsamblajeChasisLlantasPlano.SLDDRW]
2019-09-04 Creacion del codigo Funcional
    [Ensamblaje transmision.SLDASM, ISO - Straight bevel pinion 1M12PT 12GT 20PA 5FW ---12O15H10MD6.0N.sldprt, SOPORTE BALINERA.SLDPRT, Soporte Base Motor.SLDPRT, buje soporte.SLDPRT, engrane conico espiral z67.SLDPRT, pinion Transmisor.sldprt, piñon z15.SLDPRT]
2019-09-17 Organizacion de los elementos
    [Angulo 90 perfil.SLDPRT, Angulo.SLDPRT, AnguloFrontal.SLDPRT, AnguloParal.SLDPRT, Angulos.SLDPRT, Chasis Con Pala.SLDASM, Chasis.SLDASM, ChasisConBasesMotor.SLDASM]
2019-09-19 Organizacion de los elementos y arreglando chasis
    [AdaptadorM2R.SLDPRT, AdaptadorM3R.SLDPRT, Anillos Rodillo.SLDPRT, Anillos Rodillo2.SLDPRT, Assem2.SLDASM, Cepillo Completo.SLDASM, Cepillo Medio Ensamble.SLDASM, Cepillo.SLDPRT]
2019-09-19 chasis terminado
    [Canastilla.SLDPRT, Chasis Completo.SLDASM, Motor Montado.SLDASM, Soporte Principal Del Chasis.SLDASM, soporte Llantas.SLDPRT, soporte motor.SLDPRT]
2019-09-28 Creada la explosion con su video
    [Explosion Vista.SLDASM]
2019-10-15 Creacion de planos
    [Chasis Completo.SLDDRW]
2019-10-16 Creacion de manual mantenimiento
2019-11-28 planos de piezas
    [AdaptadorM2R.SLDDRW, AdaptadorM3R.SLDDRW]
2019-11-28 planos del proyecto
    [Motores Pololu.SLDPRT]
2019-11-28 planos del proyecto finales
    [Angulo 90 perfil.SLDDRW, AnguloParal.SLDDRW, Anillos Rodillo2.SLDDRW, Llanta Fija.SLDDRW, Motores Pololu.SLDDRW, Perfil Cuadrado 15cm.SLDDRW, SOPORTE BALINERA.SLDDRW, Soporte Lateral Rodillo.SLDDRW]
